YarinAVI/Practical-Engineer-Final-Project/BOOK/ספר פרויקט סופי.pdf

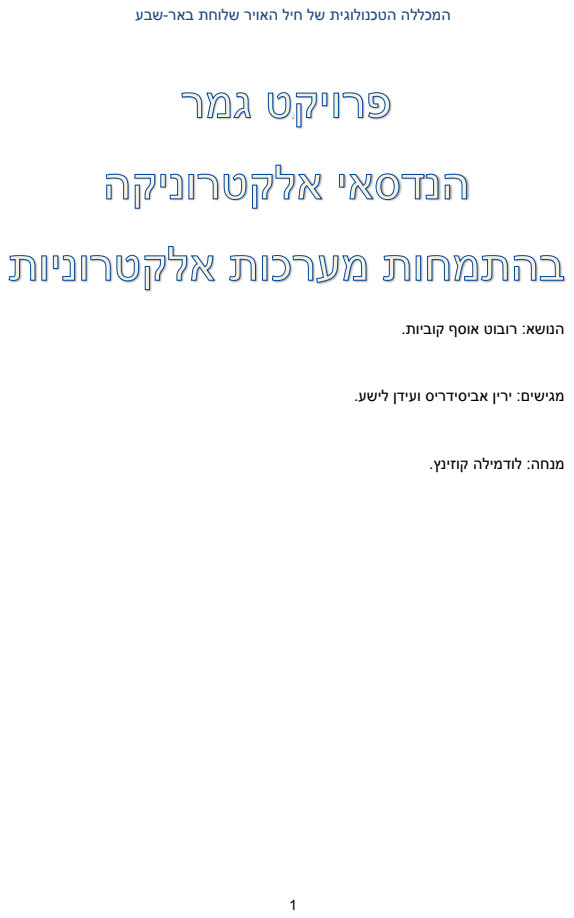
[picture p33: page 1]

המכללה הטכנולוגית של חיל האויר שלוחת באר-שבע

הנושא: רובוט אוסף קוביות.

מגישים: ירין אביסידריס ועידן לישע.

מנחה: לודמילה קוזינץ.

ברצוננו להודות למספר אנשים שעזרו, תמכו ותרמו מזמנם לעשייה וגימור הפרויקט.

בראש ובראשונה תודה למנחת הפרויקט - לודמילה קוזניץ , אשר תמיד עזרה והקשיבה לאורך כול תהליך בניית הפרויקט וכמובן הדריך והראה את הדרך הנכונה והשלבים לעשייה בצורה הטובה ביותר.

תודה למורים – ישראל זוניס ויעקב מרש, שליוו אותי במשך כול תקופת הלימודים, ונתנו לי את הידע והבסיס לעשיית הפרויקט ותמיד נענו בחיוב לעזרה בשעת הצורך.

## תוכן עניינים:

פרק 1 – מבוא

1.4 הסבר תרשים מלבנים | 8-9
8 | P89V51RD2 | בקר- | מיקרו | 1.4.1
8 | DC–L293D | למנועי | דרייבר | 1.4.2
1.4.3 מנועי DC8 |
1.4.4 מערך מקלטי/משדריIR8 |
1.4.5 חוצץ 24474HCT9 |
1.4.6 מנועי סרבו9 |
1.4.7 תצוגרת LCD9 |

פרק 2–מעגל חשמלי

2.1 סכימה חשמלי10 |
2.2 הסבר סכימה חשמלית10-34 |
11-20 | P89V51RD2 | בקר | מיקרו | 2.2.1
2.2.2 תזמון המיקרו-בקר בתדר קבוע20 |
2.2.3 מעגל ריסט )Circuit Reset ) 20 |
2.2.4 מעגל בקרת מנועים21-24 |
2.2.5 חיישן מרחק מבוסס קול אולטרסאונד )04SR-HC )26-28 |
2.2.6 ממיר מסוג STEPDOWN29 |
29 | PL-IRM0101 2.2.7
2.2.8 מנועי סרבו ) Motor Servo) 30-34 |

פרק 3 –פרוטוקולים

35-38 | )IR( RECS | פרוטוקול | 3.1

פרק 4–תוכנית

4.1 תוכנית בשפת C39 |
4.1.1 תרשים זרימה40 |
4.1.2 קבצי h41-51 |
4.1.3 תכנית ראשית52-59 |
4.1.4 הסבר פונקציות60-62 |

### פרק -5סימולציות

5.1 סימולציית PWM ב- Keil63-67 |

### פרק -6סיכום ומסקנות

6.1 סיכום ומסקנות69 |
6.2 תקלות במהלך הפרויקט69 |

### פרק -7זיווד71-73 |

### פרק -8ביביליוגרפיה

8.1 אתרים75 |

### פרק -9נספחים

76-82 | P89V51RD2 | בקר- | מיקרו | 9.1
9.2 דרייבר דוחף זרם למנוע D293L83-84 |
9.3 אפנון PWM(אפנון רוחב הפולס(85-86 |
9.4 מד מרחק (04SR(87-88 |
89 | DC Motor 9.5
9.6 מנועי סרבו (SERVO (90 |
9.7 מייצב ממותג מסוג BUCK) Down Step(91-93 |

## פרק :1

## מבוא

בפרויקט זה פותח ומומש רובוט בצורת טנק שעליו מורכבת זרוע מכנית אשר נועדה להרים חפצים מהרצפה ולהחזירם אל ארגז אשר מונח בפינת החדר .

הפרויקט מורכב מהרובוט עצמו ושלט לתפעולו של הרובוט . הרובוט מורכב מבסיס טנק בעל שני מנועי DC , גלגלים המשולבים עם רצועות גומי , מיקרו אשר משמש כליבה של המערכת ודרכו מתנהלות כול הפקודות והנתונים לשאר הרכיבים, מתח הספקה על מנת לתפעל את כול רכיבים , פרוטוקול IR שתפקידו לקלוט מהשלט מידע , מייצב מתח של v5 לרכיבים הלוגים הנמצאים במעגל , חיישן מרחק אשר יהווה עבור הרובוט כבקרה להפסקת תנועתו בהבחנת מכשול –כלומר החיישן יחובר למנוע סרבו על מנת שינוע בתנועת סריקה ימינה ושמאלה, מצב זה פועל רק במצב אוטומטי בלבד. השלט מורכב מפרוטוקול IR שתפקידו זהה ל- IR המצוי על הרובוט ובנוסף לשמש לתפעול שני מצבים של הרובוט, סוללת הספקה לשם תפעול השלט, לחצני חצים ולוח מקשים ממוספר למימוש תנועתו של הרובוט והזרוע. הרובוט יבצע את הפעולות אשר המשתמש יגדיר לו כגון : נסיעה קדימה, רברס, פניות ימינה ושמאלה תוך מתן התחשבות לסביבתו ,במצב אוטומטי כאשר הרובוט נמצא בחדר מרובע במידה וישנם מכשולים אשר מפריעים לו בדרך הוא ימנע מהם ע"י שינוי כיוון תנועתו לשם השלמת הנסיעה בצורה מושלמת ולאחר מכאן ישוב לביצוע פעולות המשתמש.

### 2.1 הוראות הפעלת המערכת

.1 מעבירים את הרובוט למצב כוח חיצוני )מתח סוללה אינו מקבל מתח מכניסת ה-usb). .2מחבברים פיזית את הכבלים של הסוללה לרובוט. .3 משתמשים במקור מתח נפרד של v5 שיכול לספק עד A3 לפי הדרישות להפעלת שלושת מנועי הסרבו של הזרוע במקביל. .4 כרגע הרובוט מוכן לקבל פקודות מהשלט כלומר הרובוט מוכן לשימוש )נסיעה+ זרוע(.

# LCD

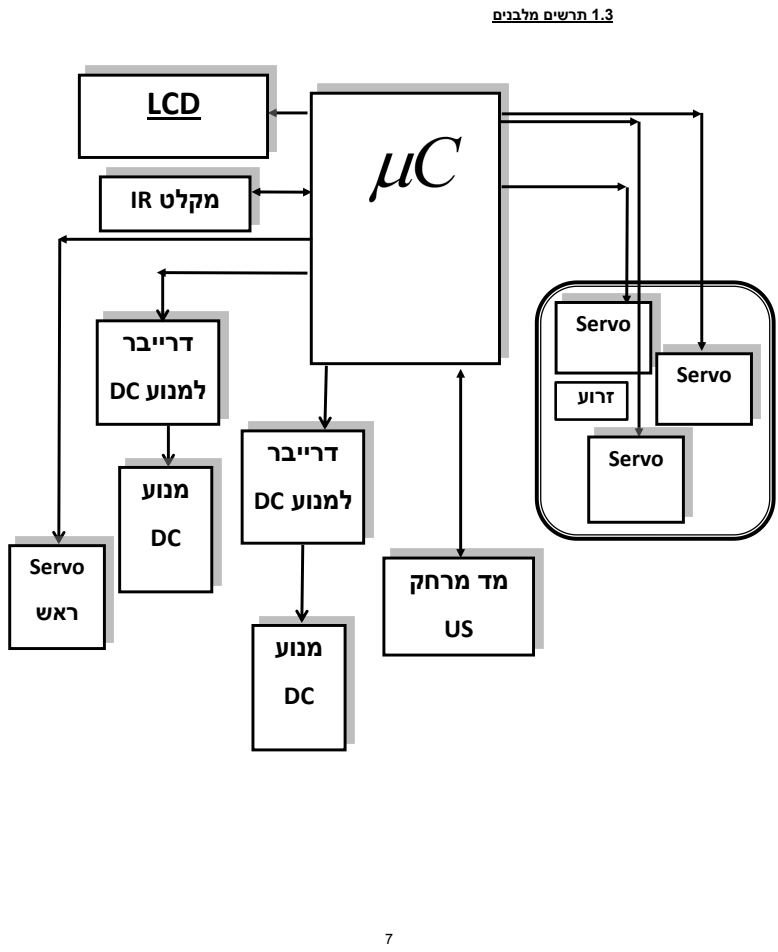
[picture p34: page 7]
1.3 תרשים מלבנים; Servo; דרייבר; למנוע DC; מקלט IR; מנוע; מד מרחק; ראש; זרוע

### 4.1 הסבר תרשים מלבנים

P89V51RD2 | בקר | מיקרו | 74.1.4

המיקרו בקר הוא היחידה המרכזית במעגל החשמלי.

תפקידו הוא לבקר על פעילות כל היחידות המחוברות אליו.

תפקידיו העיקריים של המיקרו בקר:

הפעלת מנועי ה- DC ע"י שליחת נתונים לדרייבר D293L.

עיבוד הנתונים המתקבלים מחיישני ה- IR ומחיישן ה- Ultrasonic.

יצירת פולסים מתאימים למנועי הסרבו בשביל תפעול הזרוע והזזת הראש עליו יושב החיישן מרחק.) PWM )

7L293D–DC | למנועי | דרייבר | 4.1.1

רכיב דוחף זרם אל המנועים. מחובר בין המיקרו בקר והמנועים.

תפקידו הוא לספק את הזרם הנדרש למנועים להפעילם בהתאם למידע שנשלח אליו מהמיקרו בקר.

### 4.1.1 מנועי DC7

רכיב אלקטרו מכאני, המבצע המרה של אנרגיה חשמלית לאנרגיה סיבובית מכאנית.

תפקיד המנועים הוא לסובב את הגלגלים כך שהרובוט יוכל לנסוע.

### 4.1.1 מערך מקלטי/משדרי IR7

השלט IR שולח אור red-infra אשר נקלט בעינית המקלט, המידע משודר באמצעות האור, גל הנושא שלנו מאופנן בתדר [hz[k,38 הסיביות והזמנים שלהם מוגרד לפי פרוטוקול – 80\ NEC .RECS

### 4.1.3 חוצץ 244HCT774

תפקידו להעביר את אות המבוא למוצא מבלי להעמיס על המיקרו-בקר, הגברת זרם האות שיוצא מהבקר.

תפקידו העיקרי הוא להגן על הבקר.

### 4.1.4 מנועי סרבו7

אנו משתמשים ב 3 מנועי סרבו עבור הזרוע כאשר 2 מתוכם לצירים של הזרוע ימינה\שמאלה, למעלה\למטה ומנוע אחרון לסיגרה ופתיחה של צבת הזרוע.

המנוע הרביעי משמש כ"ראש" להזזה של החיישן מרחק שמאלה וחזרה קדימה כדי לקבל משוב על המרחק של הרובוט מאובייקטים קדימה\שמאלה ועל ידי כך לצאת מהחדר שבנינו.

מנוע הסרבו שונה ממנוע ה DC בכך שהוא מקבל פולסים ולפי כך הוא מבין לאיזה כיוון הוא צריך להזיז את הגיר שלו בכדי להגיע לזווית הרצויה.

### 4.1.5 תצוגרת LCD7

רכיב LCD הוא קיצור של Display Crystal Liquid ובעברית תצוגת גביש נוזלי. הינו התקן אופטואלקטרוני אשר מסוגל להציג אותיות ,מספרים ותווים אחרים.

הוא משמש כיחידת פלט במערכת.

בעזרת ה lcd קיבלנו משוב על מדידת המרחק, השתמשנו בתצוגה כדי לראות שהרובוט נכנס למצבים שאנו רצינו להכניס אותו ובכך יכולנו לאתר שגיאות ובעיות שהיו בדרך.

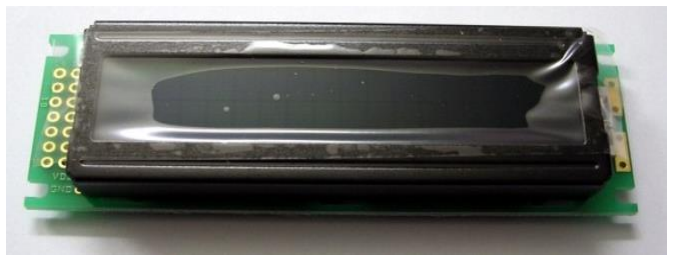
[picture p35: figure]

## פרק 71

## סכימה חשמלית

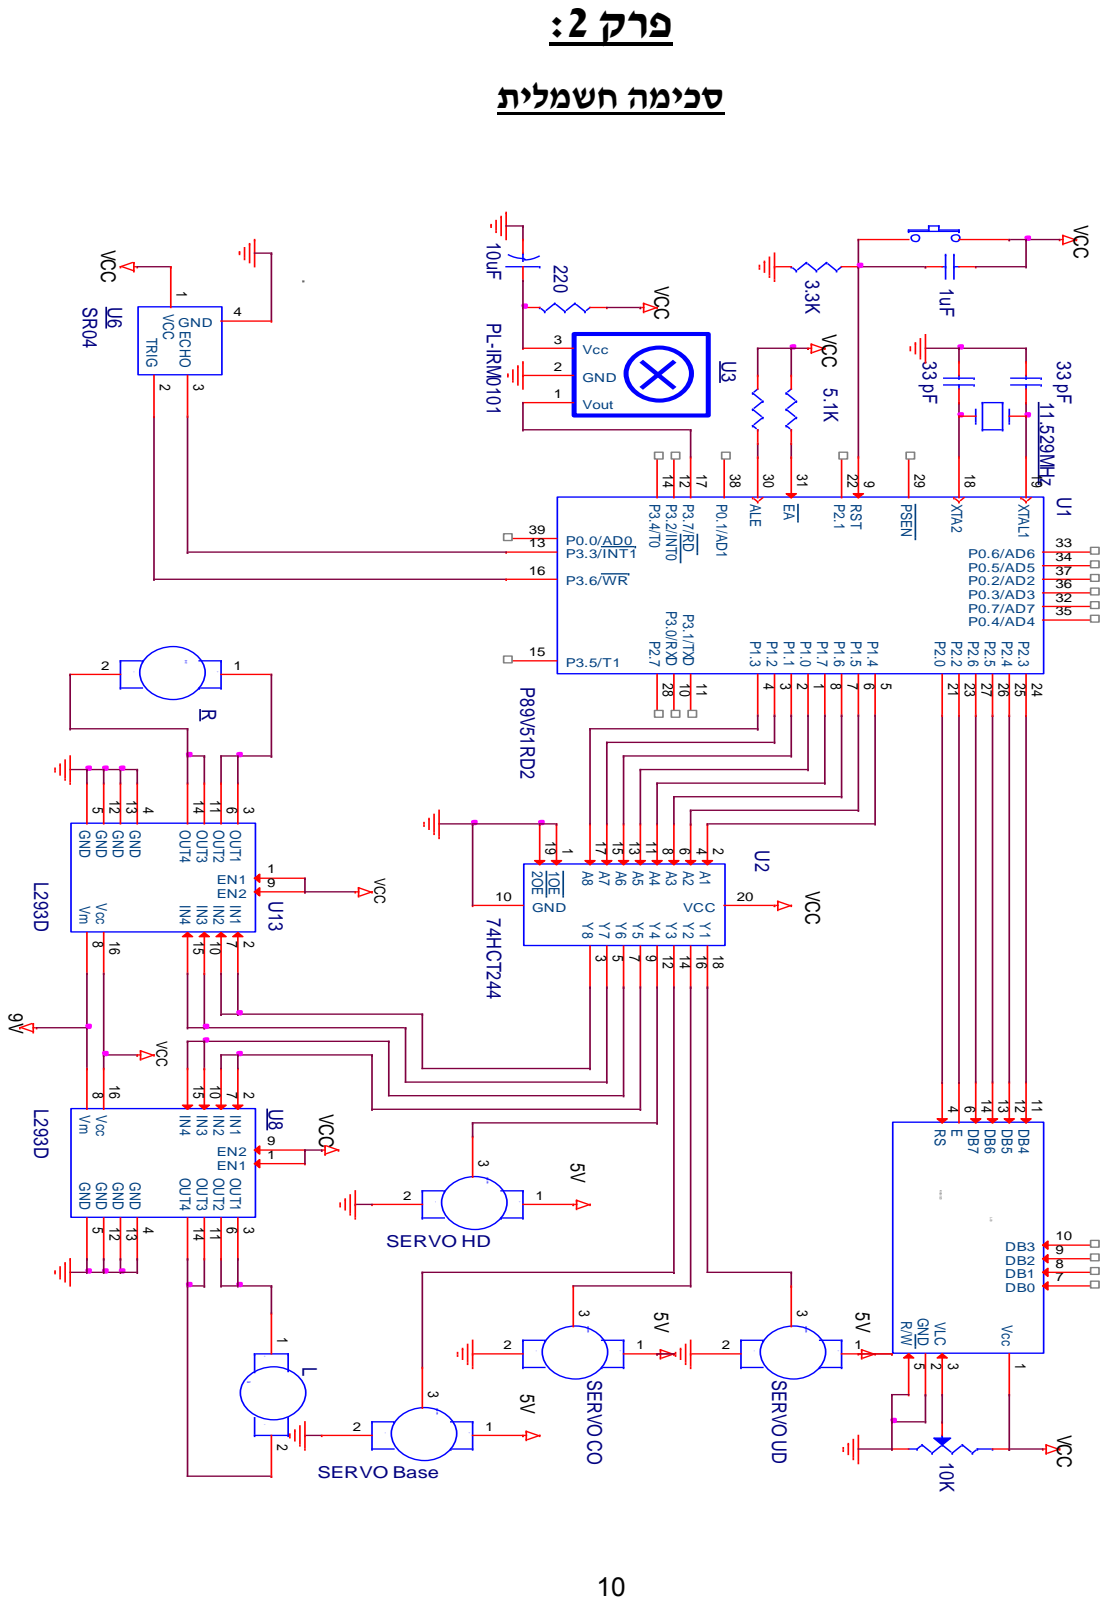
[picture p36: page 10]
OUT1; OUT2; OUT3; OUT4; GND; Vcc; 74HCT244; 12 VCC 20 GND 10; VCC; GND 2 VLC; 11.529MHz; LCD; PSEN; ALE; XTAL1; XTA2; RST; 28 P3.0/RXD 10 P3.1/TXD; P3.2/INT0; 12 P3.3/INT1 13; servo; SERVO UD; PL-IRM0101Vout; TRIG; ECHO; 3 GND

servo SERVO HD

servo SERVO CO

servo SERVO Base

### 1.1 הסבר סכימה חשמלית

7P89V51RD2 | בקר | מיקרו | 1.1.4

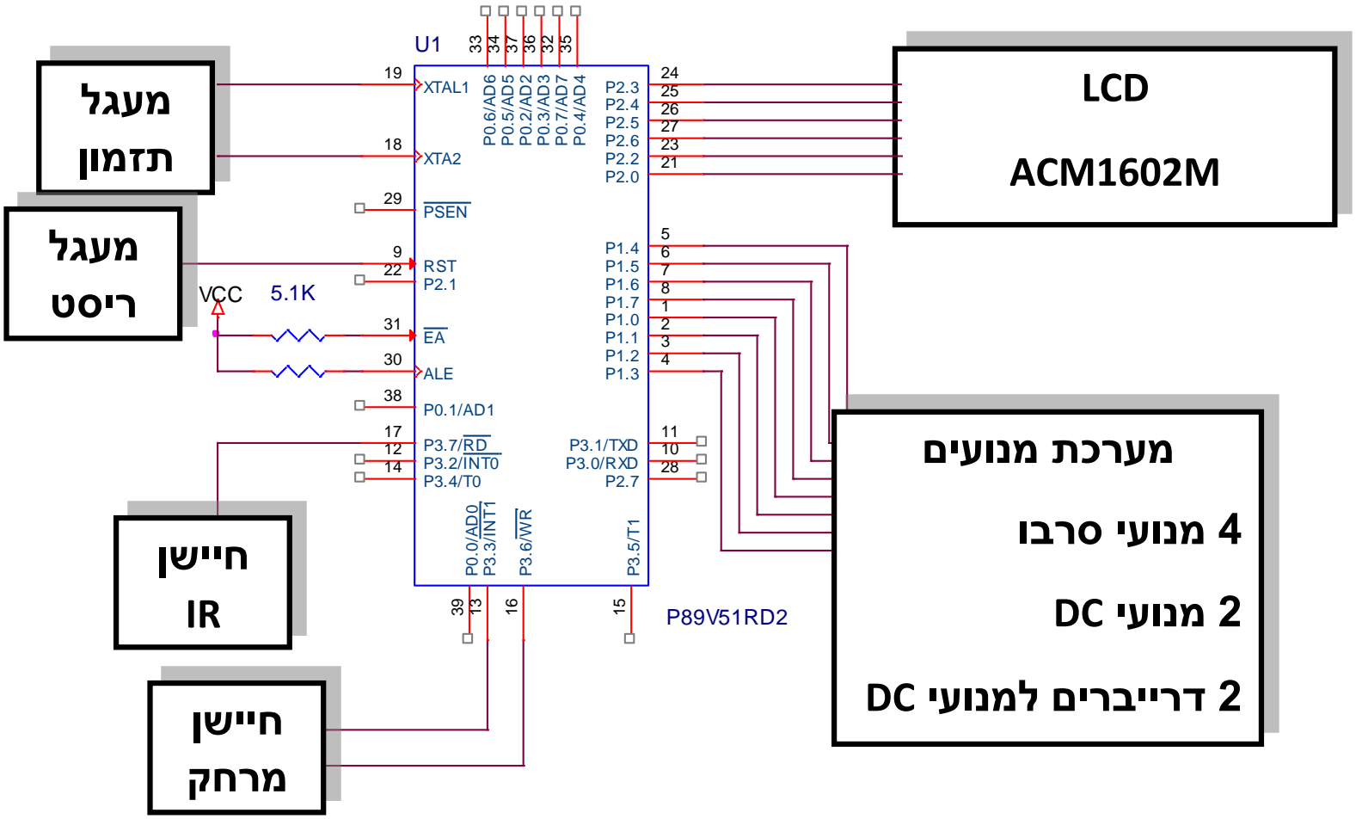
[picture p37: figure]
LCD; ACM1602M; מעגל תזמון; VCC; PSEN; ALE; XTAL1; XTA2; RST; P⁰.0/AD⁰ 39; P3.0/RXD; P3.1/TXD; P3.2/INT0; P3.3/INT1; מערכת מנועים; 4 מנועי סרבו; 2 מנועי DC; 2 דרייברים למנועי DC; מעגל ריסט; חיישן IR; חיישן מרחק

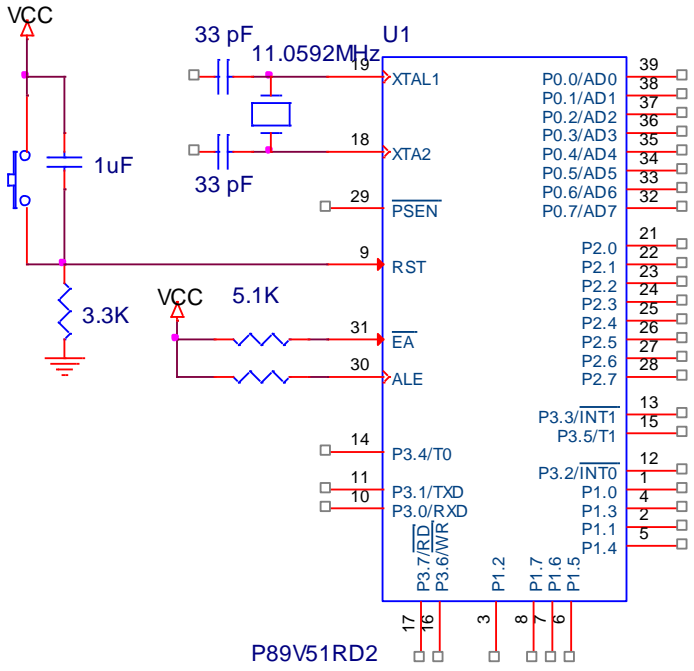
[picture p38: figure]
PSEN; ALE; XTAL1; XTA2; RST; P3.0/RXD; P3.1/TXD; P3.2/INT0; P3.3/INT1; 11.0592MHz; VCC

מיקרו בקר 2RD51V89P של חברת NXP הוא היחידה המרכזית במעגל, והוא אחראי על כל היחידות המחוברות אליו.

תפקידיו העיקריים בפרויקט:

- הפעלת המנועים על מנת שהרובוט יוכל לנסוע.
- קריאת נתונים מחיישני ה –IR לשם תנועת הרכב והזזת הזרוע .
- קריאת נתונים מחיישן ה –Ultrasonic במצב אוטומטי כדי שהרכב ידע היכן נמצאת היציאה של החדר.
- גילוי יציאת החדר.
- קריאת נתונים המתקבלים מהמחשב דרך תקשורת טורית אסינכרונית.

מאפיינים7

מאפיינים:

2RD51V89P של חברתNXP הוא מיקרו בקר מסדרת 51C80 עם זיכרון תוכנה KbytesFlash64 ו- BytesRAM.1024

CP של מיקרו בקר 51C.80

זיכרון תוכנה פנימי Flash Kbytes.64

UART משופר.

Array Counter Programmable – PCA –מערך מונים הניתנים לתכנות הכוללים פונקציית .PWM

4 פורטים של קלט/פלט מקביליים בגודל bit8 כל אחד.

3 טיימרים/מונים בגודל bit.16

Watchdog טיימר הניתן לתכנות.

8 מקורות פסיקה עם 4 רמות של עדיפויות.

תיאור חיבורים במיקרו בקר7

- הדקים 1X ו- 2X הם קווי חיבור של גביש לתזמון הרכיב כאשר תדר העבודה הוא תדר הגביש.
- 1PORT –אליו מתחברים מנועי ה-DC, הדרייברים שלהם ומנועי הסרבו של הזרוע, דרך רכיב הגנה .
למנוע אחד מתחברים ההדקים 1.0P ו- 1.1P ולמנוע השני מתחברים ההדקים 1.2P ו- 1.3P.

על מנת להפעיל את המנוע צריך להיות הפרש מתח בין הפורטים המחוברים אליו.

הדקים 1.4P עד 1.7P מחוברים למנועי הסרבו אשר מפעילים את הזרוע .

- 2.0P ו- 2.2P עד 2.6P אליהם מחובר ה- LCD המשמש לנו לבדיקת נתוני הרובוט.
- 3.7P מחובר לחיישן IR אשר נועד לקבל פקודות מהשלט IR לגבי תנועות הרובוט והזרוע על ידי פרוטוקול IR .
- 3.3P ו- 3.6P אליהם מחובר חיישן האולטרסאונד 3.3,P הדק זה הוא פסיקת 1INT המחובר להדק ה ECHO של חיישן האולטרסאונד הדק 3.6P משמש להדק ה- TRIG.

תכונות מיוחדות של המיקרו בקר7

פסיקות7

פסיקה זה גורם המפסיק את הפעילות השגרתית של המעבד.

כאשר מתקבלת פסיקה המעבד יפסיק את הרצת התכנית הראשית והוא יבצע את תכנית הפסיקה. בסיום תכנית הפסיקה המעבד יחזור לפעילות השגרתית עד שתתרחש פסיקה נוספת.

אוגרי המעבד:

. | פסיקות | אפשור | אוגר | – Interrupt enable register 0 – IEN0

0EX – אפשור פסיקה חיצונית .0

0ET – אפשור פסיקת טיימר .0

1EX – אפשור פסיקה חיצונית .1

1ET – אפשור פסיקת טיימר .1

ES – אפשור פסיקת פורט טורי.

2ET – אפשור פסיקת טיימר .2

EA – על מנת להשתמש בפסיקה כלשהי יש לעלות את EA ל-'1'. על מנת לחסום את כל הפסיקות

יש להוריד את EA ל-'0'.

שימושים של הפסיקות בפרויקט:

פסיקת 1INT פסיקה חיצונית 1 פסיקה זו קשורה למדידת המרחק בעזרת החיישן ultrasonic .

0IP – priority Interrupt – אוגר לקביעת סדר עדיפויות של הפסיקות.

על מנת לתת עדיפות גבוהה יותר לאחת הפסיקות יש לעלות את הסיבית המתאימה ל- '1'.

כאשר כמה פסיקות בעלות אותה רמת עדיפות, העדיפות תהיה בהתאם לסדר העדיפויות כך ש-0PX היא בעלת העדיפות הגבוהה ביותר.

TMOD – register control mode Counter/Timer – אוגר לבקרת אופן עבודה של טיימר/מונה.

CT – Timer/Counter – סיבית זאת קובעת פעולת מונה אירועים או טיימר.

'0' בסיבית זו קובע אופן פעולה של טיימר. )מהשעון הפנימי(.

'1' בסיבית זו קובע אופן פעולה של מונה. )כניסה מהדק Tx של המיקרו בקר(.

GATE – כאשר סיבית זו ב-'1' המונה/טיימר יופעל רק כאשר בהדק 'INTx יש '1' ובהדק TRx יש .'1'

כאשר סיבית זו ב-'0' הטיימר יופעל כאשר בהדק TRx יש '1'.

0M1,M – סיביות לקביעת אופן הפעולה של הטיימר/מונה.

הטבלה הבאה מציגה את אופני הפעולה הנפוצים יותר:

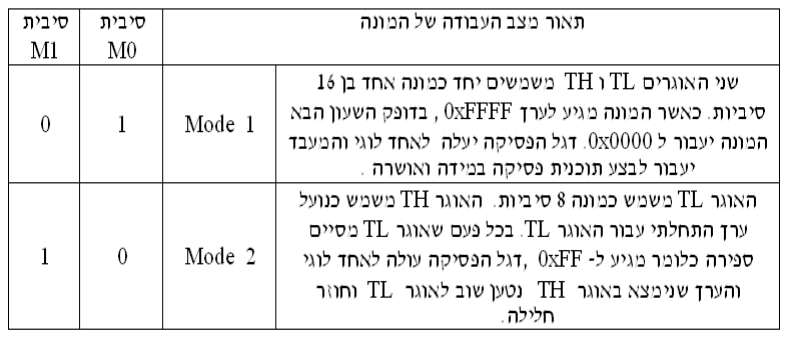
[picture p39: figure]

שימושים של הטיימרים בפרויקט:

- במצב הבקרה הידנית כאשר הרכב נתון לשליטה על ידי השלט, 0timer נמצא ב 2Mode bit8 טעינה אוטומטית כדי ליצור פולס מתאים לשליטה על מנועי הסרבו כמו שידוע מנועי הסרבו דורשים PWM כדי לסובב את הגיר שלהם לזווית הרצויה. 1Timer נמצא ב 1Mode bit16 כדי לקלוט נתונים מהחיישן IR.
- במצב הבקרה אוטומטית 0Timer נשאר באותו מצב כדי לשלוט על מנועי הסרבו, אך 1Timer כרגע עם פסיקות כדי למדוד את המרחק מחיישן ה ultrasonic השינוי זה בטבלה הבאה:

GATE של 1timer" 1 "בהגדרה זו רק כאשר הדק ה 1INT יעלה ל 1 הטיימר יחל לעבוד וכאשר ייפול ל '0' לוגי יתקבל פסיקת 1INT שהיא מטפלת במדידת המרחק.

. | טיימר | /מונה | לבקרת | אוגר | – Timer/Counter control register – TCON

0,1IT – סיביות אלו קובעות מתי תתרחש פסיקה.

'0' בסיבית זו – פסיקה תתרחש כאשר 0,1INT ברמה נמוכה.

'1' בסיבית זו – פסיקה תתרחש כאשר יש עלייה מ-'0' ל-'1' ב- 0,1INT.

0,1IE – סיבית זו עולה ל-'1' כאשר התרחשה פסיקה.

סיבית זו מתאפסת כאשר מתבצעת תכנית הפסיקה.

0,1TR – סיביות להפעלה/כיבוי של הטיימר/מונה)'1' – הפעלה, '0' – כיבוי(.

0,1TF – סיביות אלו עולות ל-'1' כאשר הטיימר/מונה סיים את הספירה.

סיביות אלו מתאפסות כאשר המעבד מבצע את תכנית הפסיקה הרלוונטית.

שימושים של אוגר זה בפרויקט:

- במצב בקרה אוטומטית של הרובוט אנו משתמשים בחיישן ה ultrasonic, ובכדי להשתמש בו אנו צריכים להגדיר את הפסיקה 1int וקבענו 1=1IT זאת אומרת תתקבל פסיקה כאשר הדק ה ECHO של החיישן ירד ל ‘0’ לוגי. להלן קטע קוד:
1. EX1=1; //enabling interrupt 1
2. TR1=1; // running timer 1, timer runs when gate is 1.
3. IT1=1; // falling edge interrupt 1
4. EA=1; // enabling all interrupts

– Programmable Counter Array – PCA

מערך המונים PCA מורכב מחמשה מודולים הניתנים לתכנות באופני עבודה שוני וממונה משותף בן 16 סיביות המורכב משני אוגרים של 8 סיביות ) CHו CL) .

אחד מאופני העבודה של ה- PCA הוא PWM שבו אנו משתמשים לבקרה על זווית גיר מנועי הסרבו.

אוגרים מיוחדים שבעזרתם מאתחלים את ה- PCA:

- PCA counter control register – CCON

CCFX – סיביות פסיקה המשמשות עבור 5 המודולים. סיביות אלו עולות ל-'1' כאשר מתרחשת פסיקה מתאימה )אנחנו לא משתמשים בסיביות אלו בפרויקט(.

CF – Flag Overflow Counter PCA – סיבית זו עולה ל-'1' כאשר המונה של ה- PCA מסיים את הספירה. ניתן להשתמש בדגל זה בשביל פסיקה של המונה.

CR – Bit Control Run Counter PCA – באמצעות סיבית זו מפעילים את המונה.

ההוראה שאנו משתמשים על מנת להפעיל את המונה:

1. CCON=0x40;

PCA counter mode register – CMOD

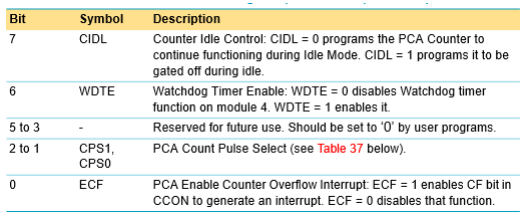
[picture p40: figure]

CIDL-בקרת מנייה במצב IDLE כאשר ‘0’ המונה ימשיך לפעול במצב ה IDLE, כאשר הוא יהיה ‘1’ הPCA לא יפעל במצב ה IDLE.

WDTE- אפשור הפעלת טיימר של WATCHDOG"( כלב שמירה" ( תפקיד הWATCHDOG בבקר היא לבדוק שהבקר עובד כשורה ועושה את כל הפעולות כמתוכנן וגם בודק שהבקר מפיק תדר שעון שזה הרי גורם חשוב בפרוייקט.

כאשר 0=WDTE טיימר של ה WATCHDOG לא יפעל וכאשר ‘1’ הטיימר יפעל.

0CPS1,CPS-סיביות אלו משמשים ב בחירת פולס מתאים לביצוע המנייה של ה PCA מתוך 4 אופציות שהיצרן מציע.

ECF- אפשור פסיקת המנייה של PCA כאשר מתקבלת גלישה, כאשר סיבית זו ‘1’ לוגי היא מאפשרת לסיבית CF באוגר CCON ליצור פסיקה, כאשר סיבית זו ‘0’ היא מחסלת אפשרות זו.

Counter pulse select options:

באמצעות הפקודה הבאה אנו בוחרים פולס ספירה מתאים בין 4 האפשרויות שהיצרן מציע, אנו בחרנו לעבוד עם גלישת 0timer כדי לבצע את הספירה.

1. CMOD=4;

CCAPMn PCA Modules Compare/Capture register

- חשוב לציין שאוגר זה רלוונטי עבור הפורטים 1.7P1.3-P שרק עבורם אפשר להוציא אות PWM עבור מנועי הסרבו, היצרן מציע 5 הדקים שעבורם אפשר להוציא PWM ברקע לתוכנית הראשית.

ECOMn-מאפשר את פעולת המשווה עבור הדק ה n,’ 1 ‘לוגי יאפשר את הפעולה.

CAPPn- אופצית ה CAPTURE חיובית עבור הדק ה n,’1 ’אומר שהוא עובד עבור עלייה חיובית.

CAPNn- אופצית ה CAPTURE שלילית עבור הדק ה n,’ 1 ‘אומר שהוא עובד עבור ירידה בהדק ה .n

TOGn- כאשר סיבית זו ‘1’ וכשיש שיוון בין המנייה של ה PCA לבין המנייה של אוגר זה הדק ה n שנבחר מבצע מיתוג בין המצב הנוכחי שלו למצב ההופך )TOGGLE)

PWMn- סיבית זו מאפשר את ההדק n להיות מוצא PWM

להלן איור שמתאר את ההדק כשהוא מתפקד עם PWM ביציאה שלו:

באמצעות אוגרים CCAPnH ו- CCAPnL קובעים את ה- Cycle Duty של האות.

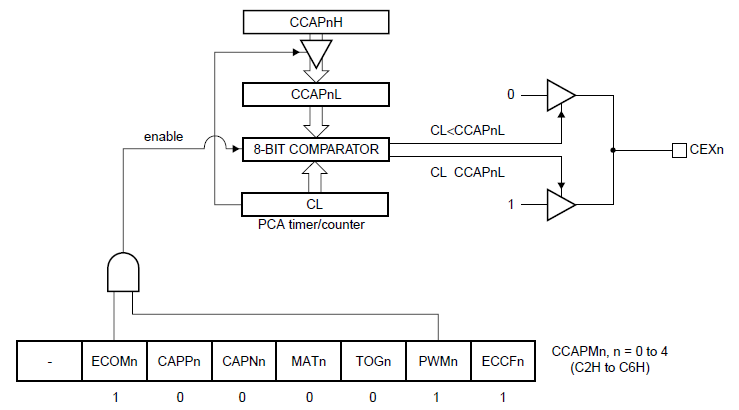
[picture p41: figure]

כשמונה מתחיל לספור, כל עוד התוכן שלו קטן מהערך באוגר CCAPnL במוצא יהיה '0'.

כאשר הערך שבאוגר CCAPnL גדול מהערך של המונה במוצא יהיה '1'.

כשמסתיימת הספירה האוגר CCAPnL נטען בערך של אוגר CCAPnH והמונה סופר מחדש, כך שמתקבל אות מחזורי במוצא עם Cycle Duty שניתן לבחירה.

בפרויקט אנו מייצרים אות PWM בהדקים 1.7P1.4-P עבור שליטה על מנועי הסרבו שאיתם אנו מזיזים את החיישן ultrasonic ושאר המנועים אשר מהווים צירים לזרוע שנמצאת על הרכב, סה"כ 3 מנועי סרבו לזרוע שלנו כאשר מנוע1 מהווה ציר אופקי המנוע השני לציר אנכי והמנוע השלישי לסגירה\פתיחה של הזרוע בכדי להרים חפצים.

### 1.1.1 תזמון המיקרו-בקר בתדר קבוע7

מעגל תזמון של המיקרו-בקר מורכב מגביש של Mhz 11.0592 ושני קבלים שערכם pF.33 מעגל זה משמש ליצירת תדר השעון הנחוץ לעבודה תקינה של מיקרו בקר )קריאה, כתיבה, הפעלת רכיבים פנימיים, קריאה לפריפריה(.

במקביל.
33ρF

כדי לקבל תדר מדויק מחברים לגביש שני קבלים בעלי ערך של

ערך הקבלים נבחר לפי דפי יצרן של המיקרו בקר. מעגל )מתנד בעל תדר MHz11.0592 ושני

קבלים אשר מכניסים אותו לתדר תהודה( מהווה רשת משוב B של מתנד קולפיץ. המגבר של מתנד

זה ממומש ע"י שער NOT פנימי שבמיקרו בקר.

השתמשנו בגביש ולא בסליל מפני שבמעגל דיגיטלי לא מומלץ להשתמש ברכיבם בעלי השראות וגם כן הגביש מדויק יותר.

מעגל תזמון משמש ליצירת תדר שעון לשם הבטחת סנכרון )כלומר לשם שמירת תדירות קבועה ויציבה של עבודת הבקר( של כל פעולות המבוצעות ע"י בקר.

הדקים 1X ו- 2X הם קווי חיבור של גביש לתזמון הרכיב כאשר תדר העבודה הוא תדר הגביש.

### 1.1.1 מעגל ריסט ) Circuit Reset) 7

מעגל הריסט שלנו ממומש באמצעות לחצן O.N קבל uF1 ונגד k3.3 חיבור הלחצן הוא בתצורת down-pull, כאשר אנו נלחץ על הלחצן זרם יזורם דרך מסלול vcc<קבל>נגד ויצור מפל מתח על הנגד שמפורש כ- HIGH בהדק ה RESET של הבקר, לפי דרישות היצרין מתח HIGH בהדק ה RESET למשך זמן של 2 זמני מכונה במקרה שלנו בערך us2 יגרמו לבקר לעשות RESET.

תפקיד הקבל הוא למנוע את בעית הריטוטים שנוצרת עקב הלחיצה המכאנית של האדם.

3.3K

1uF

VCC

RESET_CIRCUIT

RST(9)

### 2.2.4 מעגל בקרת מנועים:

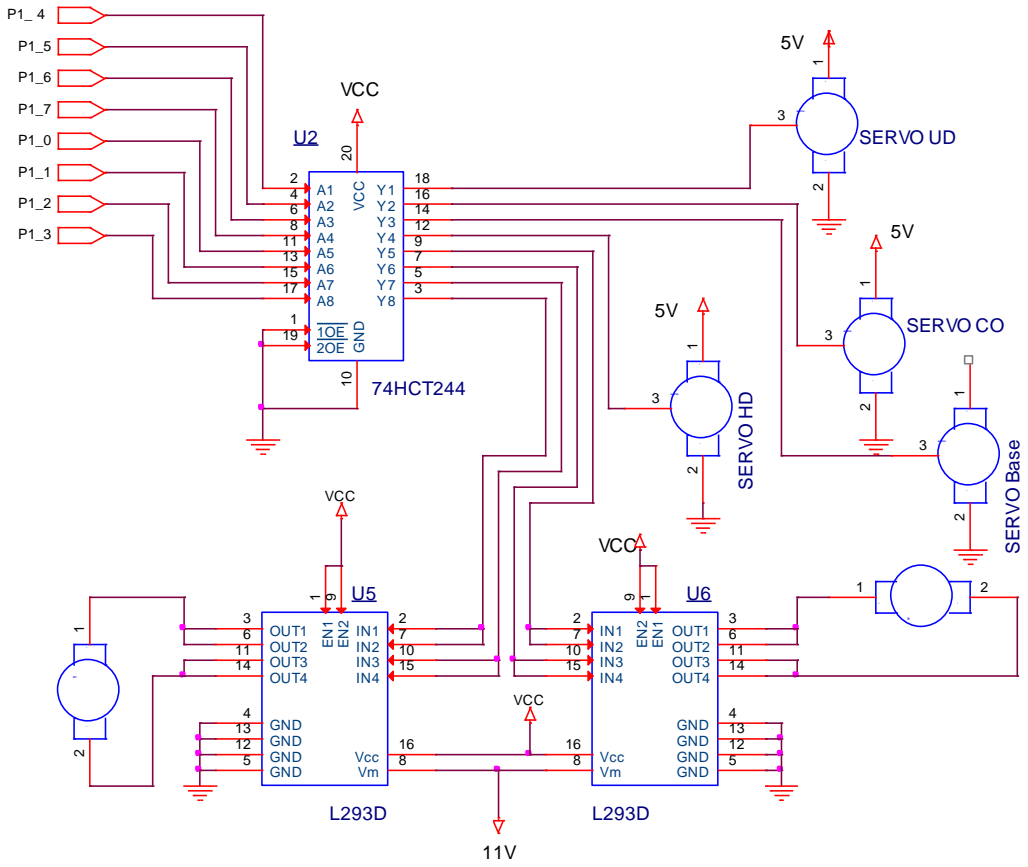
[picture p42: figure]
15 EN¹; OUT1; OUT2; OUT3; OUT4; GND; Vcc; 74HCT244; 12 VCC ²⁰ GND 10; VCC; servo; SERVO CO; EN¹; SERVO HD; SERVO UD; SERVO Base

לרובוט מחוברים שני מנועים שמטרתם היא להזיז את הרובוט קדימה, ימינה שמאלה ואחורה.

בנוסף מחוברים 4 מנועי סרבו כאשר שלוש מתוכם לשם שליטה על הזרוע של הרכב והאחרון לשם הזזה של חיישן המרחק.

מנוע DC:

רכיב אלקטרו-מכאני המבצע המרה של אנרגיה חשמלית לאנרגיה מכאנית.

מנוע DC מבוסס על עקרון האלקטרומגנטיות, המאפשר יצירת שדה מגנטי על ידי העברת זרם חשמלי דרך סליל.

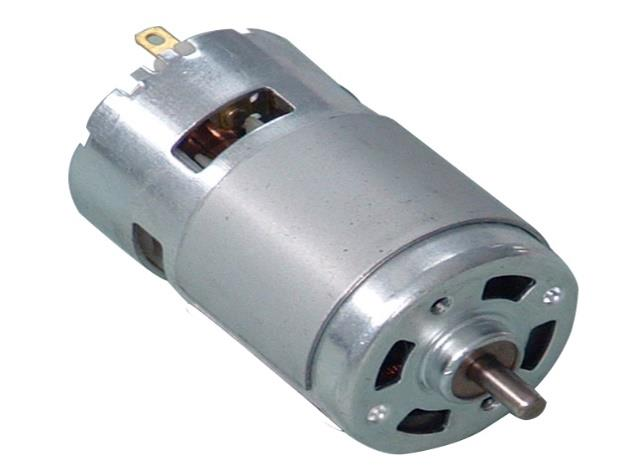
[picture p43: figure]

אספקת מתח למנועים7

- לקחנו סוללת ליתיום V11.1 בעלת הספק של mAh1000 חיברנו אותה למטריצה והיא

מוציא לנו V10 מהנקודה הזו חיברנו מתח למנועי ה DC

•חיברנו בנוסף ממיר STEPDOWN שיורד את המתח למתח נמוך יותר שמתאים למננועי ה

SERVO שהוא מתאים לפי דרישות היצרן ל (v-7.4v5 (בחרנו לעבוד עם V6 ובכך הצלחנו

להפעיל 2 מנועי DC ו 4 מנועי סרבו בעזרת סוללה אחת ברור שההספק של המנועי סרבו משתנה ותלוי האם הזרוע מרימה חפץ או האם אנו משתמשים בזרוע תוך כדי נסיעה.

דרייבר דוחף זרם D293L:

תפקיד הדרייבר הוא לספק זרם למנועים, מכיוון שהזרם שהמיקרו בקר יכול לספק מהפורטים שלו לא מספיק גדול בשביל הפעלת המנועים.

כל ערוץ )מוצא של הדרייבר( יכול לספק עד A.0.5 אנו מחברים שני ערוצים לכל מנוע על מנת

לאפשר זרם של עד A.1

הדקים 1EN ו- 2EN מאפשרים את הערוצים 1,2OUT ו- 3,4OUT בהתאמה, כמוראה בטבלה:

H – רמה גבוהה

L – רמה נמוכה

X – לא רלוונטי

Z – עכבה גבוהה

הידק Vcc – מתח של V5 מסופק לכניסות הלוגיות כדי לצמצם בזבוז הספק.

הידק Vm – מתח המוצא של הרכיב - V10 לכל מנוע.

תפקיד נוסף של הדרייבר הוא להפעיל את המנוע בשני כיוונים ע"י ספק יחיד באמצעות מעגל -H

:Bridge

Input | EN | Output
H | H | H
L | H | L
X | L | Z

ניתן לראות שעל ידי שינוי המתח בכניסות של הדרייבר אפשר למתג את המנוע בשני כיוונים שונים ומתח האספקה הוא עדיין Vm.

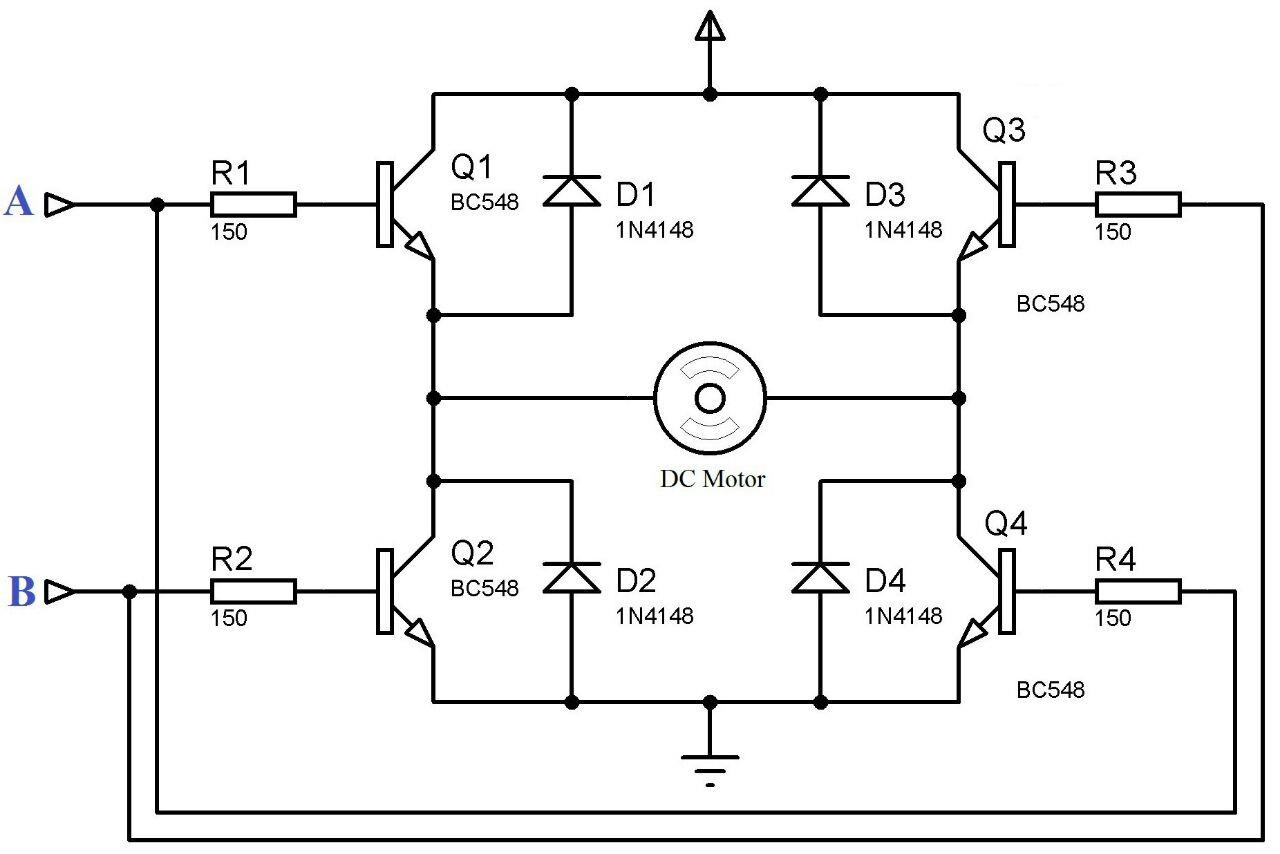
[picture p44: figure]

דיודת הגנה

המתגים שבמעגל BRIDGE-H הם טרנזיסטורים ולכן יש צורך להוסיף דיודת הגנה שתהיה מחוברת במקביל למנוע )עומס השראי(.

ב-D293L הדיודה בתוך הדרייבר ולכן הוסיפו את האות D לשם הדרייבר.

במצב מתמיד הזרם זורם דרך הסליל אשר מתנהג כקצר דרך הטרנזיסטור שנמצא ברוייה.

הבעיה היא כשמנתקים את 1V הטרנזיסטור נמצא בקיטעון ובגלל שאין קפיצות זרם בסליל הוא לא מספיק להתפרק.

במצב זה ללא דיודת הגנה הטרנזיסטור היה נשרף אך אם נחבר את דיודת ההגנה ניתן לראות שכשהטרנזיסטור נכנס לקיטעון מתח הסליל משנה את קוטביותו והוא מתפרק דרך הדיודה וכך הדיודה מגנה על הטרנזיסטור.

בזמן הטעינה של הסליל שינוי הזרם הוא חיובי אך בזמן הפריקה שינוי הזרם הוא שלילי ולכן המתח משנה קוטביות.

בקרה על סיבוב המנועים:

על מנת לגרום למנועים להזיז את הרובוט לכיוון מסוים יש לשלוח נתונים לפורטים להם מחוברים הדרייברים של כל מנוע. הנתונים הדרושים לפעולה זו מתוארים בטבלה הבאה:

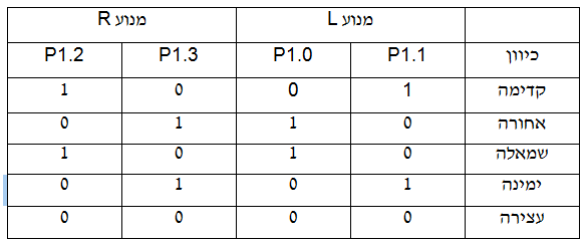
[picture p45: figure]

רכיב חוצץ – 244HCT774

תפקידו הוא להפריד בין המיקרו בקר לבין מעגל בקרת המנועים.

244HCT74 הוא חוצץ ל- bit8 עם 3 מצבי מוצא, לרכיב יש שני מוצאים של bit4 הנשלטים ע"י

הדקי OE.

פעולת הרכיב מתוארת בטבלה הבאה:

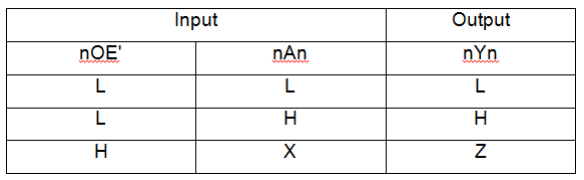
[picture p46: figure]

אנו מחברים את הדקים 'OE1 ו- 'OE2 לאדמה על מנת לאפשר את שני המוצאים, כדי שכל נתון שנשלח לחוצץ יעבור לדרייברים של המנועים.

### 1.1.1 חיישן מרחק מבוסס קול אולטרסאונד )04SR-HC):

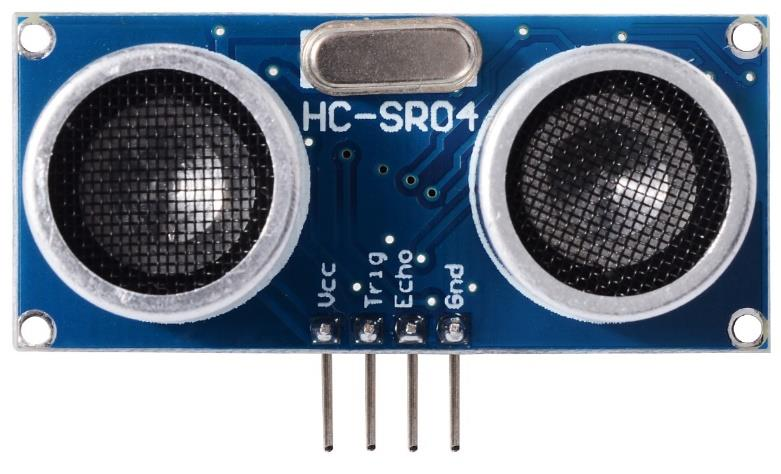
[picture p47: figure]
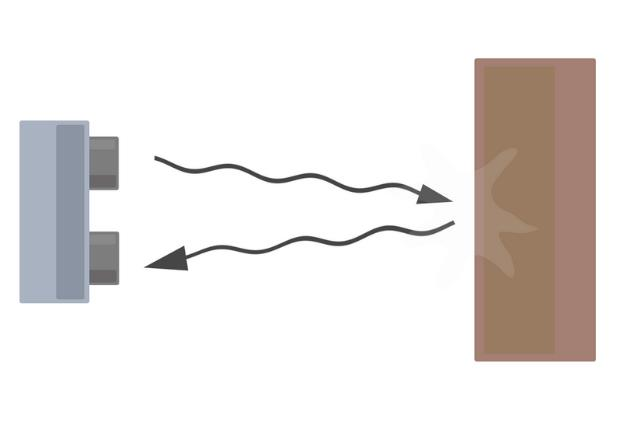
[picture p48: figure]

חיישן זה כולל משדר ומקלט, החיישן משדר קול אולטראסוני כאשר הוא מרגיש מתח HIGH ברגל ה- TRIGGER למשך זמן של לפחות us,10 לאחר סיום השידור של הקול האולטראסוני רגל ה ECHO עולה ל מתח HIGH עד שהמקלט מקבל את הקול חזרה ) זאת אומרת שהקול הספיק לחזור חזרה אל החיישן ( לפי הנתונים הללו ניתן להבין שהקול ביצע דרך כפולה, זאת אומרת הוא הספיק לפגוע באובייקט שנמצא מולו ולחזור חזרה אל המקלט ולכן את המרחק אשר נמודד בעזרת הTIMER בתוכנה נחלק ב.2

בעזרת הTIMER נמדוד את הזמן שלקח לקול האולטראסוני לחזור אל החיישן ובכך יהיה ניתן

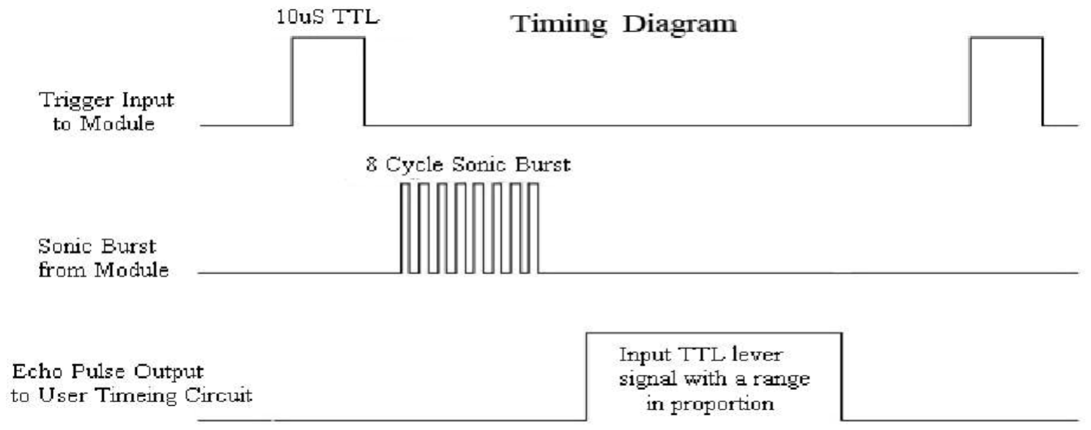
[picture p49: figure]

לחשב את המרחק מהאובייקט שממולו.

P3_6

VCC

US_SENSOR

U4
SR04

VCC

1

TRIG

2

ECHO

3

GND

4

P3_3

נשתמש בנוסחא ובטבלת יחידת המרת K הבאה :

| | ערך המרהK( מהירות( V( טמפרטורה( C ºt
0 | 331.5 | 60
10 | 337.5 | 59
20 | 343.5 | 58
30 | 349.5 | 57

בחרנו לעבוד עם ערך המרה 58=K כאשר טמפרטורת העבודה שלנו היא 20 מעלות.

בתוכנה הזמן שנמדד יחולק ב 58 ובכך יתקבל המרחק המדויק עבור טמפרטורת עבודה של 20 מעלות.

נשאלת השאלה כיצד אפשר לבצע מדידה מדויקת של מרחק בעזרת חיישן זה ?

על ידי הוספת חיישן טמפרטורה שבעזרתו נדע את טמפרטורת העבודה שלנו ובכך בעזרת התוכנה נוכל לבחור ערך המרה K מתאים ובכך נגיע למדידה מדוייקת של המרחק.

1. void us_trig() {// trigger function for ultrasonic sensor
2. trig=1;
3. nop();nop();nop();// delay of 14us
4. trig=0;
5. msec(50);
6. }

פונקציה למימוש ה TRIGGER שהיצרן דורש להוציא בהדק ה TRIGGER של החיישן יש לציין שהדרישה שלו היא פולס של us10 לפחות כאשר אנחנו נתתו לו us,14 בנוסף לכך יש לציין שלפי דרישות היצרן חייב להיות רווח של ms50 לפחות בין כל פולס ברגל ה TRIGGER.

1. void distance() interrupt 2{//interrupt function (echo fa lls int1 interrupt(
2. time =TH1;
3. time =time<<8;//shift left 8
4. time =time|TL1; //
5. dist=time/58;
6. TH1=TL1=0;
7. flag=1;
8. }

פונקציה זו היא פונקצית-פסיקה והתוכנית תכנס אליה רק אחרי שיצרנו פולס לחיישן בעזרת הפונקציה ()trig_us, כאשר הדק 3.3 של הבקר ירד ל-"0" לוגי תתקבל פסיקת 1INT מסוג edge-falling, רגל 3.3 של הבקר מחוברת לרגל ה ECHO של החיישן, ECHO עולה ל-"1" לוגי לאחר מתן TRIGGER וסיום שידור הקול ויפול ל-"0" לוגי כשהקול יחזור אל החיישן. בזמן ש ECHO נמצא ב-"1" לוגי 1TIMER רץ ומודד את הזמן שהוא נמצא ב-"1" לוגי ומפסיק למדוד כאשר הוא נופל ל-"0" לוגי, מיד מתקבלת פסיקה ותוכנית ישר קופצת לפונקציה זו כדי לטפל במדידת הזמן. למשתנה dist נכנס המרחק שנמדד ביחידות CM.

K

t s
V

V t s t s
S

[ ]

| 2/ [ ]
2
* [µ ] | µ | µ
= | = | =

חשוב לציין שאנו משתמשים בחיישן זה אך ורק כאשר אנו מפעילים את המצב האוטומטי כאשר הוא מתוכנת לצאת מחדר מרובע, ובכך הרובוט מחליט את כיוון הנסיעה לפי תוכנית שכתבנו ומשתמש בחיישן המרחק ככלי מפתח.

הטיימר שלנו עובד לפי זמן המכונה של הבקר שהינו בערך us,1 זאת אומרת הטיימר שלנו מונה זמן ב microseconds, מהירות הקול לפי הטבלה עבור טמפרוטת עבודה של 20 מעלות 343m/s הינה

אנו מעוניינים לקבל את המרחק מהחיישן ביחידות CM ולכן יש להמיר את המהירות ל US/CM, להלן הדרך:

| 340 | /
340*100 | 34000 | /
1sec 1
1000000
34000 ( | / | ) | 0.034 | /
1000000
2 | 2 | 58.823
( | / | ) | 0.034
v | m | s
v | cm | cm | s

us

v cm | us | cm | us

k
v cm us

=
= | =

=

= | =
= | = | =

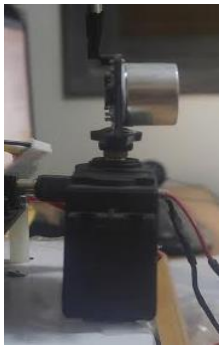
[picture p50: figure]
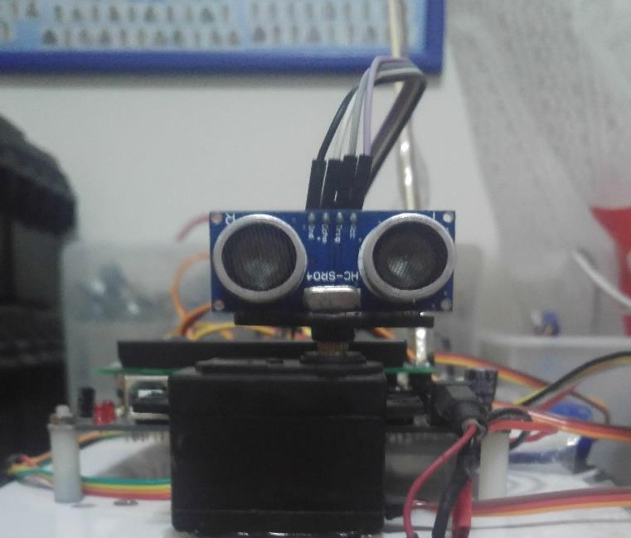
[picture p51: figure]

כמו שאפשר לראות בתמונות למעלה חיישן המרחק שלנו יושב על מנוע הסרבו, כאשר החיישן פונה קדימה )כיוון הרכב( הוא נמצא בזווית 0 של גיר המנוע, לפי נתוני היצרן ניתן לסובב את הגיר המנוע 120 מעלות,כאשר אנו צריכים במקרה שלנו רק 90 מעלות כדי לגרום לחיישן לדגום את המרחק משמאל הרכב, ובכך נדע איפה יש יציאה מהחדר המרובע שבנינו לו, כך הוא מקבל פיידבאק מהעולם החיצון ובעזרת הנתונים הללו הוא מקבל החלטות האם להמשיך ליסוע קדימה או לפנות שמאלה או האם הוא הגיע לפינה ועליו לבצע פניה ימינה ולהמשיך ליסוע לאורך הקיר.

### 1.1.2 ממיר מסוג STEPDOWN7

אנו מחברים את הכניסה של ממיר זה לנקודה שבה יוצא מתח גם למנועי ה DC ומורידים את המתח לאיזור ה V6 בכדי לעבוד עם מנועי ה SERVO. היציאות של ממיר זה מתחברות להדקי ה VCC של ארבעת מנועי ה SERVO בפרויקט.

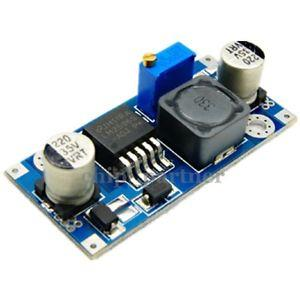
[picture p52: figure]

7PL-IRM0101 1.1.3

המעגל המתואר משמש לקליטת מידע מהמשדר( שלט).

מעגל זה מכיל רכיב 0101-3IRM-PL הממיר מידע מ IR -

לאות דיגיטלי בתחום תדרים.KHz 46 - 36 בפרויקט זה אנו

משדרים למקלט אות בתדר KHz.38

בנוסף המעגל מכיל קבל ונגד לפי דרישות היצרן.

את היציאה מהמשדר יש לחבר להדק במיקרו-בקר. בפרויקט זה הדק המוצא Vout של הרכיב

מחובר להדק 3.7 PORT של המיקרו-בקר, על מנת לגלות את האות המשודר מהשלט-משדר ה

IR ולשלוט במכשירים הביתיים.

המידע שמתקבל במודול IR שודר לפי פרוטוקל IR( 80 – RECS – מוסבר בהמשך בפרק פרוטוקלים(.

U3

PL-IRM0101Vout

1

GND

2

Vcc

3

VCC

220

10uF

P3_7

### 2.2.8 מנוע SERVO:

מנוע ה SERVO כולל בתוכו מנוע DC אך עם מערכת בקרה על זווית סיבוב הגיר של המנוע כאשר הוא מוגבל לזווית של 120 מעלות מקסימום.

מנוע זה כולל 3 הדקים בשונה ממנוע ה DC הרגיל להלן ההדקים והסבר עליהם:

•GND – הדק האדמה.

•VCC- הדק המתח VCC עבור המנוע.

•SIGNAL- להדק זה אנו שולחים את האותות PWM על מנת לשלוט על הזווית שלו.

להלן דוגמא לאות ה PWM שהיצרן דורש בכדי לשלות על זווית הגיר של מנוע ה SERVO:

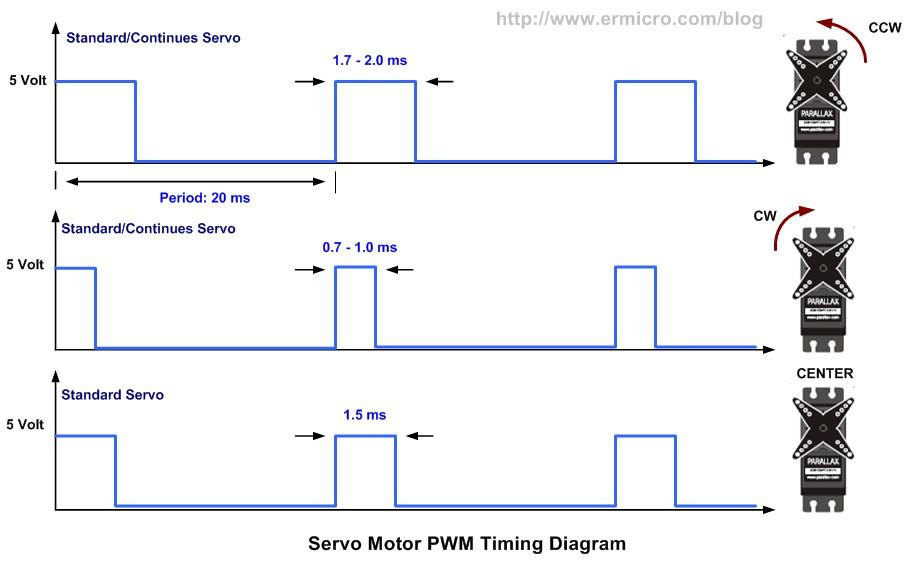
[picture p53: figure]

כפי שאפשר לראות אנו שולטים על זווית גיר המנוע על ידי שינוי של זמן ה C.D של האות כאשר הוא נע בין ms-2ms,1 בתחום הזה אפשר לשלוט על זווית גיר המנוע בין 0-120 מעלות במנועים בפרויקט שלנו, יש מנועי סרבו שמציעים טווח רחב יותר של זוויות או טווחים קטנים יותר, C.D של ms2 יזיז את גיר המנוע לזווית המקסימלית 120 מעלות.

הבקר שלנו 2RD51V89P מסוגל להוציא PWM מ 5 הדקים 1.7P1.3-P כאשר אנו השתמשנו רק ב ,4 1.7P1.4-P, על מנת ליצור אות זה אנו צריכים להשתמש במונה ה PCA של הבקר Array Counter Programmable ויש להגדיר את האוגרים שלו ואת תצורת המנייה שלו, להלן הסבר שכולל חלקים מהתוכנית הראשית כיצד יצרנו את האות PWM המתאים עבור המנועים.

אוגר בקרת ה- PCA:

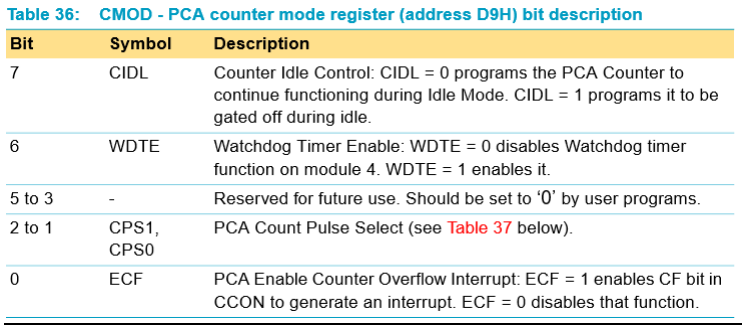
[picture p54: figure]

כאשר אותנו מעניין רק תצורת המנייה של ה-PCA נשנה את ה סיביות 0CPS1-CPS בכדי לבחור פולס מנייה מתאים מתוך ארבעת האופציות שהיצרן מציעה להלן האפשרויות והפקודה בכדי לבחור את המצב:

CMOD=4;

בחרנו להשתמש באופציה ה שלישית שהיא גלישת טיימר ,0 בחרנו להשתמש באופציה זו בגלל שאפשר לקבוע את טיימר אפס בתצורת מנייה של bit8 טעינה אוטומטית, הטיימר מונה מ ערך מסויים שבהמשך נחשב וכאשר הוא מגיע לערך המקסימלי עבור bit8 שזה FF, אוטומטית ברקע התוכנית הראשית אוגר ה TL נטענן עם הערך של אוגר ה TH של מונה זה, זאת אומרת שאפשר להתחיל את המנייה כל הזמן מחדש ברקע לתוכנית הראשית ולכן בחרנו באופציה זו.

בכדי להגדיר את הטיימר בתצורה זו כתבנו את הפקודה הבאה12:x0=TMOD פקודה זו תגדיר את טיימר 0 בתצורת bit8 טעינה אוטומטית ובנוסף תגדיר את טיימר 1 בתצורת 16 ביט ללא טעינה אוטומטית, השתמשנו בטיימר 1 עבור קליטת נתונים ממקלט ה IR.

כיצד ה PCA עובד?

PCA יכול להיות מונה/ טיימר, ואנו בחרנו לעבוד איתו לשם יצירת PWM כאשר אנו עובדים איתו לשם PWM הוא הופך ל bit8 ואת זה אנו מבצעים על ידי אפשור ה PWM עבור הדקי הבקר שרשומים מעלה, להלן אוגר הבקרה אשר אחרי לאפשור ה PWM עבור הדקים אלו )1.7P1.3-P ) כאשר יש אוגר בקרה כזה לכל הדק בנפרד.

להלן האוגר ואיזה ערך נתנו לו בכדי לאפשר לו להוציא אות PWM, בנוסף לכך כחלק מתהליך יצירת האות אפשרנו את פעולת המשווה בין אוגר ה PCA לבין אוגר ה CCAPL שהוא אוגר נפרד לכל פורט.

1. CCAPM1=0x42;
2. CCAPM2=0x42;
3. CCAPM3=0x42;
4. CCAPM4=0x42;

לאחר רצף פקודות אלו אפשרנו את פעולת ה PWM עבור ההדקים 1.7P1.4-P ואת פעולת המשווה בין אוגר ה CCAPL שהוא נפרד לכל הדק לבין אוגר ה CL שהוא אוגר ה PCA שהוא משותף לכל ההדקים.

לאחר בחירה של פולס מנייה מתאים בעזרת CMOD, שבמקרה שלנו כל גלישה של טיימר 0 מונה ה PCA יתקדם ב1 כאשר הערך המקסימלי שאליו הוא יגיעה בסוף המנייה הוא FF.

נשאלת השאלה כיצד אנו ניצור אות PWM בתדר hz50 לפי דרישות היצרן עבור מנועי הסרבו ולהלן החישובים שעשינו בכדי לתת ערכים מתאימים לאוגרי הטיימר 0 ואוגרי ה CCAPH של כל הדק )CCAPH נטענן ל CCAPL בכל גלישת אוגר ה CL, זה קורה בכדי שלא יהיו הפרעות, בעצם המתכנת מעדכן את CCAPH וCCAPL נשאר קבוע ומתעדכן אך ורק בכל גלישה של אוגר ה CL.)

תחילה נחשב את זמן המחזור T:

1
20
50
T | ms
hz

לאחר מכן אנו מסתכלים על טיימר 0 ומבינים

= =

שהגדרנו אותו בתצורת bit,8 זאת אומרת שהערך המקסימלי שהוא יוכל למנות הוא 255 ולכן נבצע

את הפעולה הבאה:

20 | 78
0( | 0 | )
| ms
us
TIMER TL MAX

, זאת אומרת שכל

TL MAX 0 | 255 =
כאשר

=

us78 צריכה להיות גלישת טיימר 0 הטיימר שלנו עובד בקצב הזמן מכונה של הבקר שהינו us,1.085

זאת אומרת שהטיימר שלנו ימנה 255 פולסי זמן מכונה של הבקר זאת אומרת us1.085*255 שיוצא

us276 כאשר אנו צריכים לקבל גלישה רק אחרי us78 ולכן אנו נצטרך להתחל את אוגרי הטיימר

בערך שונה מ 0 בכדי לקבל את הזמן הזה ולכן :

78 | 71( | ) 49( | )
1
us | dec | hex
tmachine

כאשר

= | =

, אז נבצע פעולת חיסור בין הערך המקסימלי של האוגר לבין הערך 49)HEX)

tmachine | us =1.085

, זאת אומרת את הערך 8B נצטרך לתת לאוגרי ה 0TH ו ה 0TL
FF hex | hex | B ( | ) 49( | ) | 8 - | =
ולכן
בתחילת התוכנית כדי לקבל גלישת טיימר כל us.78

אם כל us78 מתבצעת קידום של אוגר ה CL ב 1 אפשר לומר: ואנו רואים שבאמת נוצר
CL MAX ( ) 255 =

כאשר
78 * | ( | ) 19.89 | 20 us CL MAX | ms | ms = | →
אות בזמן מחזור של ms20 שהינו תדר של hz.50

להלן קוד בתחילת התוכנית כדי לתת לאוגרי ה טיימר ערכים מתאימים כפי שחישבנו :

1. TH0=0xB8;
2. TL0=0xB8;

3. TR0=1;

1=0TR בכדי להפעיל את פעולת הטיימר של טיימר ,0 להלן איור שמתאר את שינוי הלוגי של כל ההדקים שאפשרו להם פעולת PWM כתלות באוגר ה PCA - CL.

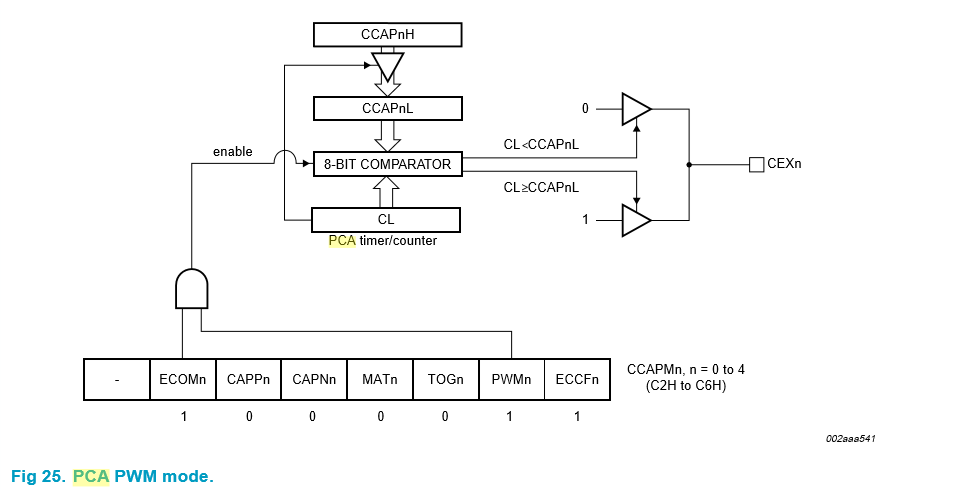
[picture p55: figure]

*חשוב לציין שאיור זה מתאים עבור כל הדק שאליו אנו עובדים עם PWM.

אוגר ה CL מתחיל את המנייה שלו מערך 0 עד ערך מקסימלי של FF ובכדי לשנות את ה C.D של אותו הדק נצטרך לשנות את ערך אוגר ה CCAPL כאשר לכל הדק יש אוגר כזה נפרד, את השינוי אנו לא עושים ישירות, זאת אומרת שאנו משנים את CCAPH ו CCAPL נטענן לערך CCAPH אך ורק אחרי גלישת אוגר ה CL( כאשר CL הגיעה ל FF ואז התבצעה עוד מנייה זאת אומרת הוא יתאפס ל 0 (

כעט נסביר איך מתבצעת שינוי ב C.D של האות ה PWM בעזרת שינוי של אוגר ה CCAPL.

כפי שניתן לראות באיור ההדק של הפורט שאיתו אנו עובדים בPWM יהיה ב רמה לוגיית נמוכה – ‘0’ כאשר אוגר ה CL קטן בערכו מאוגר ה CCAPL, ו יהיה ברמה לוגית גבוהה כאשר CL יהיה גדול בערכו מאוגר ה CCAPL. כעט נחשב איזה ערך צריך לתת לאוגר ה CCAPL בכדי לקבל C.D של ms1 עבור האות שהוא כולו ms20 – hz50 כפי שהיצרן דורש.

אנו יודעים שרק אחרי גלישת טיימר 0 שזה כל us78 אוגר ה CL יתקדם ב .1 ולכן בכדי לקבל רמה לוגית גבוהה – ‘1’ לוגי במוצא ההדק למשך זמן של ms1 עבור האות שכולו ms20 לפי נתוני היצרן אות כזה ברגל ה SIGNAL של המנוע תזיז את גיר המנוע לזווית ה 0 כפי שניתן לראות בגרף שצורף בתחילת ההסבר על מנועי הסרבו, להלן החישוב :

( | (max) | )*78 | 1
(max) 255
20 | 78 | 1
78 | 19
| 243.58 | 244
CL | X | us | ms
CL
m | uX | ms
uX | m
X
- =
=
- =
=
= | →

לכן נתנו לאוגר CCAPH את הערך 244 בכדי לקבל C.D של ms1 בתדר של hz50 בתחילת התוכנית כמובן שניתן לשנות את אוגר ה CCAPH בכדי לשלות על הזווית כעט נחשב את הערך שצריך לתת לאוגר זה בכדי להגיע לזווית המקסימלית של המנוע שהינה 120 מעלות, ה C.D הדרוש עבור זווית זו הוא ms2 להלן החישוב:

( | (max) | )*78 | 2
(max) 255
20 | 78 | 2
78 | 18
18 | 230
78
CL | X | us | ms
CL
m | uX | ms
uX | ms
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
לאחר החישובים הללו אנו מבינים שערך של אוגרי ה CCAPL עבור כל הדק שהגדרנו לשימוש מנועי סרבו ינוע בין 244-230 כאשר 244 היא הזווית ה 0 ו 230 היא הזווית המקסימלית 120 מעלות.

לאחר כל ההגדרות והחישובים שביצענו בכדי ליצור את האות לפי דרישות היצרן נשאר להפעיל את פעולת המונה של ה PCA להלן האוגר CCON שהינו אוגר הבקרה של מונה זה

נתנו לאוגר זה את הערך 40x0=CCON בכדי להפעיל את פעולת המנייה על ידי שינוי סיבית ה CR כאשר סיבית זו ‘1’ לוגי אז מונה ה PCA יתחיל לעבוד.

# פרק 73

# פרוטוקולים

:IR-RECS-80 | פרוטוקול
- אור אינפרא אדום )תת אדום( הוא קרינה אלקטרומגנטית באורך גל הגדול מזה הנראה בעין.
- אורכי הגל נעים בטווח של 750 ננומטר עד 30,000 ננומטר.
- שימושים בקרינה זו:
מצלמות הרואות ביום ובלילה. תקשורת בין מכשירים.
ועד לחימום.
בפרויקט שלנו אנו משתמשים בפרוטוקול זה על מנת ליצור קשר בין השלט לבין הרכב בכדי שיוכל לבצע את תנועותיו. לבקר מחובר חיישן IR אשר קולט את הנתונים מהשלט וכך יודע לבצע את פעולות הרכב.

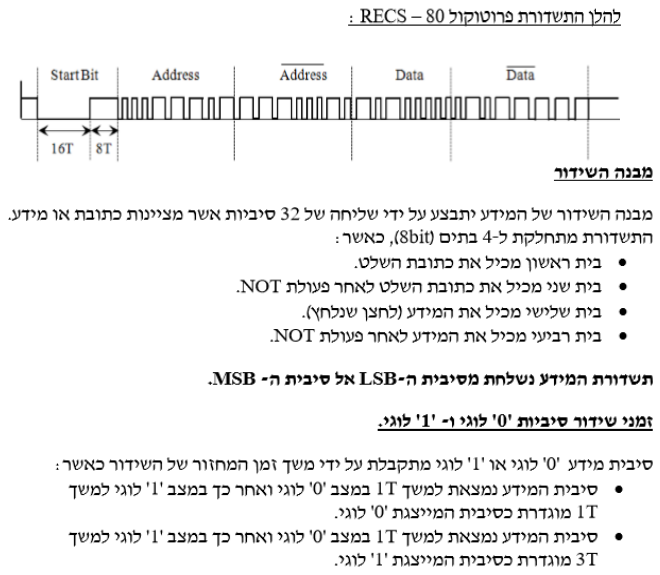
[picture p56: figure]

נשאלת השאלה מדוע השלט משדר את המידע וכתובת השלט פעמיים, פעם אחת רגיל ופעם אחת אחרי פעולת ?NOT דבר זה קורה בכדי לבדוק שהתקשורת אכן אמינה ולא לקלוט שגיאות ובכך לקלוט נתונים שלעולם לא נשלחו באמת, באמצעות הבקר אנחנו עושים פעולת

NOT למידע שנשלח כ NOT ואז אנחנו מקבלים את המידע ומשווים את המידע המקורי למידע שהיתקבל לאחר פעולת NOT על המידע שהיה NOT המידע.

זהיו תקין של הזמנים מתקבל לפי הטבלה הזו אפשר לראות התאמה בין הבדיקה עצמה בשורות הקוד שהוספתי למטה לבין הנתונים בטבלה.

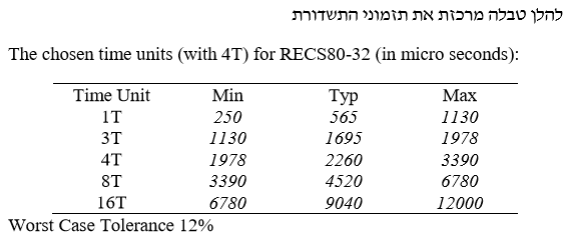
[picture p57: figure]

להלן קטע קוד מתוך הפונקציה ()remote bit אשר מזהה את T16 שהוא חלק מ- START :BIT

1. TL1=TH1=0;
2. TR1=1;
3. while(!bit_IR);//bit_IR up
4. TR1=0; //stop timer
5. time_units =TH1;
6. time_units =time_units <<8;//shift left 8
7. time_units =time_units |TL1; //
8. if(time_units <11060 && time_units >6248)// check 16T
9. {

לאחר זיהוי תקין של פרק זמן של T16 ברמה לוגית נמוכה התוכנית ממשיכה לבדיקת זמן של T8 ברמה לוגית גבוהה כאשר היא מהווה את החלק השני של ה BIT START.

1. TL1=TH1=0;
2. TR1=1;
3. while(bit_IR);//bit_IR down
4. TR1=0; //stop timer
5. time_units =TH1;
6. time_units =time_units <<8;
7. time_units =time_units |TL1;
8. if(time_units <6248 && time_units >3124)
9. {

לאחר זיהו תקין של פרק זמן של T8 ברמה לוגית גבוהה התוכנית סיימה לפענח את ה BIT START וממשיכה לפענוח ה ADDRESS של השלט כאשר הסיבית ‘0’ ו ‘1’ מוגדרות כך:

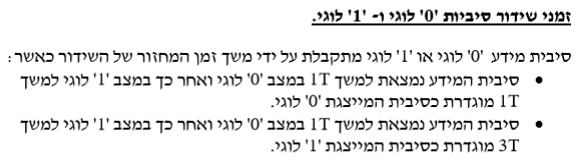
[picture p58: figure]

1. for(len_arr=0;len_arr<4;len_arr++)
2. {
3. num=0;
4. for(num_bit=0;num_bit<8;num_bit++)
5. {//==== 1T =======//
6. while(!bit_IR);//bit_IR up
7. //===== 3T ======//
8. TL1=TH1=0;
9. TR1=1;
10. while(bit_IR); //bit_IR down
11. TR1=0; //stop timer
12. time_units =TH1;
13. time_units =time_units <<8;
14. time_units =time_units |TL1;
15. if(time_units <1823 && time_units >1041)//3t
16. num|=1<<num_bit;
17. }//for8
18. arr_remote[len_arr]=num;
19. }

לולאה זו רצה 4 פעמים כאשר הפעם הריאשונה היא מפענחת את ADDRESS לאחר מכן היא מפענחת את ADDRESS NOT ולאחר מכן DATA ואחרי זה את DATA NOT. לאחר שהיא מסיימת לקבל את ארבעת הבתים הללו היא בודקת האם התקשורת אמינה על ידי פעולת NOT על כתובת שנשלחה כ NOT ועל המידע שנשלח כ NOT בכדי לבצע השווה בין המידע המקורי ולבין המידע שנשלח כ NOT וכך רואים אם התקשורת אכן תקינה, להלן הקטע קוד שאחרי לכך:

1. if(arr_remote[0]==~arr_remote[1]) //address && !address
2. if(arr_remote[2]==~arr_remote[3])
3. return 1;
4. return 0;

אם ADDRESS שווה ל NOT של ADDRESS NOT זאת אומרת אם ADDRESS שווה ל ADDRESS אז אכן יש תקשורת אמינה לאחר מכן הוא מבצע את אותה פעולה על DATA ו

DATA NOT בכדי לבדוק שוב כדי לוודאות שהתקשורת אכן אמינה. אם הבדיקות היו תקינות הפונקציה תחזיר 1 בנוסף לכך בתוך המערך []remote_arr נמצאים הנתונים של ADDRESS ADDRESS NOT DATA DATA NOT בסדר עולה מ 0 עד 3 זאת אומרת שבמקום ה 2 של המערך remote_arr נמצא ה DATA שלנו.

# פרק 71

# תוכנית

### 1.4 תכנית בשפת C

### 1.4.4 תרשים זרימה7

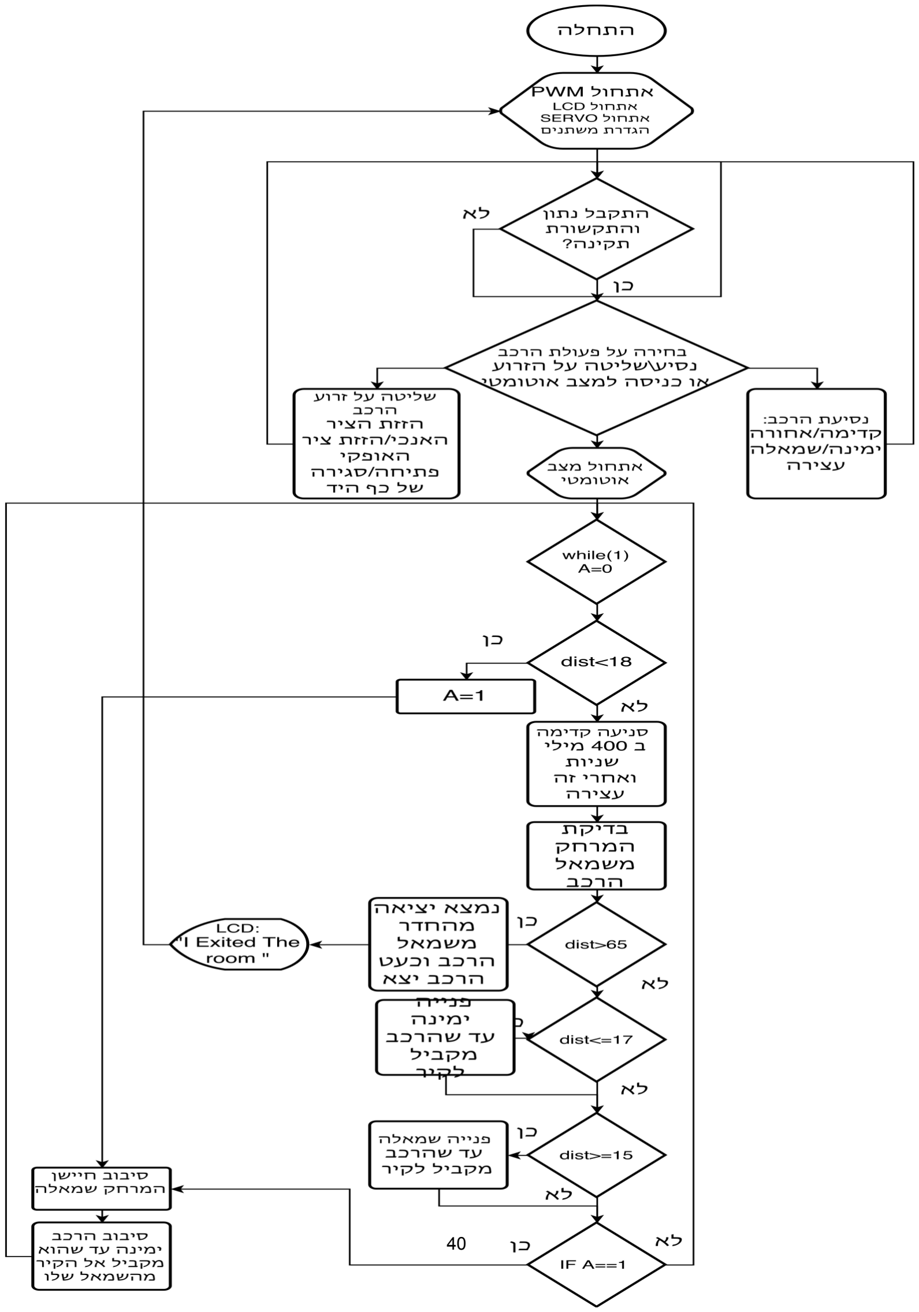
[picture p59: page 40]

### 1.4.1 קבצי h7

General.h

1. // for P89V51RD2
2. #ifndef __general_h__
3. #define __general_h__
4.
5. typedef unsigned char byte;
6. typedef unsigned int uint; 7.
8. #define ACK 0
9. #define NACK 1
10. #define TRUE 1
11. #define FALSE 0
12. //================= IR CODES DEFINED =============== ==============
13. #define _0 22
14. #define _1 12
15. #define _2 24
16. #define _3 94
17. #define _4 8
18. #define _5 28
19. #define _6 90
20. #define _7 66
21. #define _8 82
22. #define _9 74
23. #define _plus 64
24. #define _minus 25
25. #define _play 21
26. #define _right 9
27. #define _left 7
28. #define _test 68
29. #define _spin 67
30. #define _menu 71
31. #define _shutdown 69
32. //=============================== end ir codes defin e===============================
33.
34.
35. void msec(uint ms);
36. void nop(void);
37.
38.
39. void nop(void){ } // delay 5usec 40.
41.
42. void msec(uint ms)
43. {

44. uint n;
45. uint i;
46. //ms=ms*4.11;
47.
48. for (n=0; n<ms; n++)
49. {
50. for (i=0; i<112; i++);
51. }
52. }
53.
54. void usec(uint us)
55. {
56. while(us--) nop();
57. }
58. #endif

Lcdp2.h

1. //======================================================= ====================
2. // | "lcdp2.h"
3. //======================================================= ====================
4. #ifndef __lcd_4_h__
5. #define __lcd_4_h__
6.
7. #define RS_lcd | P2_0
8. #define RW_lcd | P2_1
9. #define E_lcd | P2_2
10. | #define DATA_lcd | P2
11.
12. //================================================== =========================
13. void set_lcd1(bit char_command,byte lcd_d)
14. {
15. RW_lcd = 0 ;
16. E_lcd = 0 ;
17. RS_lcd = char_command ;
18. DATA_lcd &= 0x87;
19. DATA_lcd |= ((lcd_d &0xf0 )>>1);
20. E_lcd = 1 ;
21. nop();
22. E_lcd = 0 ;
23. msec(3);
24. }
25.
26. void set_lcd(bit char_command,byte lcd_d)
27. {
28. RW_lcd = 0 ;

29. E_lcd = 1 ;
30. RS_lcd =char_command ;
31. DATA_lcd &= 0x87;
32. DATA_lcd |= ((lcd_d &0xf0 )>>1);//write 4bit High
33. E_lcd = 1 ;
34. nop();
35. E_lcd = 0 ;
36.
37.
38. RW_lcd = 0 ;
39. E_lcd = 1 ;
40. RS_lcd = char_command ;
41. DATA_lcd &= 0x87;
42. DATA_lcd |= ((lcd_d &0x0f )<<3);//write 4bit Low
43. E_lcd = 1 ;
44. nop();
45. E_lcd = 0 ;
46. msec(3);
47.
48.
49. }
50.
51.
52. //================================================== =========================
53. /*
54. I/D -
when high, cursor moves right DDRAM addr. inc. by 1
55. -
when low, cursor moves left DDRAM addr. dec. by 1
56. SH - Shift of entire display
57. | D | -
Display on/off (high = on; low = off; Data stored)
58. | C | -
Cursor on/off (high = on; low = off; ID | stored)
59. | B | -
Cursor blink on/off (high = blink on; low = blink off)
60. S/C - 1 - display; 0 - cursor;
61. | R/L - 1 - right; | 0 - left;
62. DL - Interface data length ( 1 - 8 bit; 0 -
4 bit;)
63. | N | - Display line number (1 - two lines; 0 -
one line;)
64. | F | - Display font type (1 - 5x11; 0 - 5x8;)
65. */
66. //================================================== =========================

67. void init_lcd()
68. {
69.
70. msec(50); // Recovery time after power on 71.
72. | set_lcd1(0,0x30);// 0 0 1 DL N F 0 0 | -
FUNCTION SET - 8bit interface
73. | set_lcd1(0,0x30);// 0 0 1 DL N F 0 0 | -
FUNCTION SET - 8bit interface
74. | set_lcd1(0,0x30);// 0 0 1 DL N F 0 0 | -
FUNCTION SET - 8bit interface
75. | set_lcd1(0,0x2C);// 0 0 1 DL N F 0 0 | -
FUNCTION SET - 4bit interface
76.
77. | set_lcd(0,0x2C);// 0 0 1 DL N F 0 0 | -
FUNCTION SET - 4bit interface
78.
79. | set_lcd(0,0x0c);// 0 0 0 0 1 D C B | -
DISPLAY ON/OFF CONTROL
80.
81. set_lcd(0,0x06);// 0 0 0 0 0 1 I/D SH -ENTRY MODE SET
82.
83. set_lcd(0,0x14);// 0 0 0 1 S/C R/L 0 0 -CURSOR OR DISPLAY SHIFT
84.
85. | set_lcd(0,0x01);// 0 0 0 0 0 0 0 1 | -
DISPLAY CLEAR
86.
87. }//init_lcd()
88.
89. void lcd_puts(byte location,const byte *str)
90. {
91. set_lcd(0,location);
92. while(*str) set_lcd(1,*str++);
93. } //lcd_put_str(byte location,const byte *str)
94. void lcd_clr() {
95. set_lcd(0,0x01);
96. }
97. #endif
98.
99.
100. //================================================== =========================
101. | // | End Of File "lcd_p2.h"
102. //================================================== =========================

REG89C51.h

1. //======================================================= ====================
2. // | "REG89C51.h"
3. //======================================================= ====================
4.
5. #ifndef __REG_89C51_H__
6. #define __REG_89C51_H__
7.
8. /* interrupts vectors */
9. #define EXT0_INTERRUPT 0
10. #define TIMER0_INTERRUPT 1
11. | #define EXT1_INTERRUPT | 2
12. #define TIMER1_INTERRUPT 3
13. #define SERIAL0_INTERRUPT 4
14. #define TIMER2_INTERRUPT 5
15. | #define PCA_INTERRUPT | 6
16. #define SERIAL1_INTERRUPT 7
17. | #define EXT2_INTERRUPT | 8
18. | #define EXT3_INTERRUPT | 9
19. | #define EXT4_INTERRUPT | 10
20. | #define EXT5_INTERRUPT | 11
21. | #define WDT_INTERRUPT | 12
22.
23. /* BYTE Register */
24. | sfr CKCON | = 0x8F;
25. | sfr B | = 0xF0;
26. | sfr SP | = 0x81;
27. | sfr DPL | = 0x82;
28. | sfr DPH | = 0x83;
29. | sfr TMOD | = 0x89;
30. | sfr TL0 | = 0x8A;
31. | sfr TL1 | = 0x8B;
32. | sfr TH0 | = 0x8C;
33. | sfr TH1 | = 0x8D;
34. | sfr IP | = 0xB8;
35. | sfr ICON | = 0xFF;
36. | sfr CKSEL | = 0x85;
37. sfr OSCCON = 0x86;
38. | sfr FCON | = 0xD1;
39. | sfr EECON | = 0xD2;
40. | sfr EETIM | = 0xD3;
41.

42.
43. /* PORT

0 */
44. sfr P0

= 0x80;
45. sbit P0_7

= P0^7;
46. sbit P0_6

= P0^6;
47. sbit P0_5

= P0^5;
48. sbit P0_4

= P0^4;
49. sbit P0_3

= P0^3;
50. sbit P0_2

= P0^2;
51. sbit P0_1

= P0^1;
52. sbit P0_0

= P0^0;
53.
54. /* PORT

1 */
55. sfr P1

= 0x90;
56. sbit P1_7

= P1^7;
57. sbit P1_6

= P1^6;
58. sbit P1_5

= P1^5;
59. sbit P1_4

= P1^4;
60. sbit P1_3

= P1^3;
61. sbit P1_2

= P1^2;
62. sbit P1_1

= P1^1;
63. sbit P1_0

= P1^0

;
64.
65. sbit CEX4

= P1^7;
66. sbit CEX3

= P1^6;
67. sbit CEX2

= P1^5;
68. sbit CEX1

= P1^4;
69. sbit CEX0

= P1^3;
70. sbit ECI

= P1^2;
71. sbit T2EX

= P1^1;
72. sbit T2

= P1^0;
73.
74. /* PORT

2 */
75. sfr P2

= 0xA0;
76. sbit P2_7

= P2^7;
77. sbit P2_6

= P2^6;
78. sbit P2_5

= P2^5;
79. sbit P2_4

= P2^4;
80. sbit P2_3

= P2^3;
81. sbit P2_2

= P2^2;
82. sbit P2_1

= P2^1;
83. sbit P2_0

= P2^0;
84.
85. /* PORT

3 */
86. sfr P3

= 0xB0;
87. sbit P3_7

= P3^7;
88. sbit P3_6

= P3^6;
89. sbit P3_5

= P3^5;
90. sbit P3_4

= P3^4;

91. sbit P3_3 = P3^3;
92. sbit P3_2 = P3^2;
93. sbit P3_1 = P3^1;
94. sbit P3_0 = P3^0;
95.
96. | sbit RD | = P3^7;
97. | sbit WR | = P3^6;
98. | sbit T1 | = P3^5;
99. | sbit T0 | = P3^4;
100. sbit INT1 = P3^3;
101. sbit INT0 = P3^2;
102. sbit TXD = P3^1;
103. sbit RXD = P3^0;
104.
105. /* PORT 4 */
106. | sfr P4 | = 0xC0;
107. sbit P4_7 = P4^7;
108. sbit P4_6 = P4^6;
109. sbit P4_5 = P4^5;
110. sbit P4_4 = P4^4;
111. sbit P4_3 = P4^3;
112. sbit P4_2 = P4^2;
113. sbit P4_1 = P4^1;
114. sbit P4_0 = P4^0;
115.
116. /* PORT 5 */
117. | sfr P5 | = 0xE8;
118. sbit P5_7 = P5^7;
119. sbit P5_6 = P5^6;
120. sbit P5_5 = P5^5;
121. sbit P5_4 = P5^4;
122. sbit P5_3 = P5^3;
123. sbit P5_2 = P5^2;
124. sbit P5_1 = P5^1;
125. sbit P5_0 = P5^0;
126.
127.
128. /* ACC */
129. | sfr | ACC | = | 0xE0;
130. | sbit ACC_7 | = | ACC^7;
131. | sbit ACC_6 | = | ACC^6;
132. | sbit ACC_5 | = | ACC^5;
133. | sbit ACC_4 | = | ACC^4;
134. | sbit ACC_3 | = | ACC^3;
135. | sbit ACC_2 | = | ACC^2;
136. | sbit ACC_1 | = | ACC^1;
137. | sbit ACC_0 | = | ACC^0;
138.
139. /* PCON */

140. sfr PCON = 0x87;
141. sbit SMOD = 0x8E;
142. sbit SMOD1 = 0x8E;
143. sbit SMOD0 = 0x8D;
144. | sbit POF | = 0x8B;
145. | sbit GF1 | = 0x8A;
146. | sbit GF0 | = 0x89;
147. | sbit PD | = 0x88;
148. | sbit IDL | = 0x87;
149.
150.
151. /* TCON */
152. | sfr TCON | = | 0x88;
153. | sbit TF1 | = | TCON^7;
154. | sbit TR1 | = | TCON^6;
155. | sbit TF0 | = | TCON^5;
156. | sbit TR0 | = | TCON^4;
157. | sbit IE1_ | = | TCON^3;
158. | sbit IT1 | = | TCON^2;
159. | sbit IE0_ | = | TCON^1;
160. | sbit IT0 | = | TCON^0;
161.
162.
163. | /* | SCON | */
164. | sfr | SCON_1 = | 0xC0;
165. | sfr | SCON | = | 0x98;
166. | sbit SM0 | = | SCON^7;
167. | sbit FE | = | SCON^7;
168. | sbit SM1 | = | SCON^6;
169. | sbit SM2 | = | SCON^5;
170. | sbit REN | = | SCON^4;
171. | sbit TB8 | = | SCON^3;
172. | sbit RB8 | = | SCON^2;
173. | sbit TI | = | SCON^1;
174. | sbit RI | = | SCON^0;
175.
176. | sfr | SBUF_1 = | 0xC1;
177. | sfr | SBUF | = | 0x99;
178.
179. | sfr BRL | = | 0x9A;
180.
181.
182. | sfr WDTRST = | 0xA6;
183. | sfr WDTPRG = | 0xA7;
184.
185. | sfr AUXR1 | = | 0xA2;
186.
187. | /* | IE | */
188. | sfr | IE | = | 0xA8;

189. | sfr | IE0 | = | 0xA8;
190. | sbit EA | = | IE^7;
191. | sbit EC | = | IE^6;
192. | sbit ET2 | = | IE^5;
193. | sbit ES | = | IE^4;
194. | sbit ET1 | = | IE^3;
195. | sbit EX1 | = | IE^2;
196. | sbit ET0 | = | IE^1;
197. | sbit EX0 | = | IE^0;
198.
199. | sfr SADDR | = | 0xA9;
200.
201.
202. | sfr SADDR_1 = | 0xAA;
203.
204.
205.
206. | sfr AUXR | = | 0x8E;
207.
208. | sfr SADEN | = | 0xB9;
209.
210. | sfr SADEN_1 = | 0xBA;
211.
212. | sfr IPH | = | 0xB7;
213. | sfr IPH0 | = | 0xB7;
214.
215. | sfr IPL | = | 0xB8;
216. | sfr IPL0 | = | 0xB8;
217.
218. sbit PPC = IPL^6;
219. sbit PT2 = IPL^5;
220. | sbit PS | = IPL^4;
221. sbit PT1 = IPL^3;
222. sbit PX1 = IPL^2;
223. sbit PT0 = IPL^1;
224. sbit PX0 = IPL^0;
225.
226.
227. | /* | T2CON | */
228. | sfr | T2CON = | 0xC8;
229. | sbit TF2 | = | T2CON^7;
230. | sbit EXF2 | = | T2CON^6;
231. | sbit RCLK | = | T2CON^5;
232. | sbit TCLK | = | T2CON^4;
233. | sbit EXEN2 = | T2CON^3;
234. | sbit TR2 | = | T2CON^2;
235. | sbit CT2 | = | T2CON^1;
236. | sbit CPRL2 = | T2CON^0;
237.

238.
239. | /* T2MOD | */
240. | sfr T2MOD | = | 0xC9;
241. | sfr RCAP2L = | 0xCA;
242. | sfr RCAP2H = | 0xCB;
243. | sfr TL2 | = | 0xCC;
244. | sfr TH2 | = | 0xCD;
245.
246. | sfr BDRCON = | 0x9B;
247.
248. | sfr BDRCON_1 = | 0x9C;
249.
250.
251. | /* | PSW */
252. | sfr PSW | = | 0xD0;
253. | sbit CY | = | PSW^7;
254. | sbit AC | = | PSW^6;
255. | sbit F0 | = | PSW^5;
256. | sbit RS1 | = | PSW^4;
257. | sbit RS0 | = | PSW^3;
258. | sbit OV | = | PSW^2;
259. | sbit UD | = | PSW^1;
260. | sbit P | = | PSW^0;
261.
262.
263. | /* | CCON */
264. | sfr CCON | = | 0xD8;
265. | sbit CF | = | CCON^7;
266. | sbit CR | = | CCON^6;
267. | sbit CCF4 | = | CCON^4;
268. | sbit CCF3 | = | CCON^3;
269. | sbit CCF2 | = | CCON^2;
270. | sbit CCF1 | = | CCON^1;
271. | sbit CCF0 | = | CCON^0;
272.
273.
274. | // | CMOD | //
275. | sfr CMOD | = | 0xD9;
276. | sfr CCAPM0 = | 0xDA;
277. | sfr CCAPM1 = | 0xDB;
278. | sfr CCAPM2 = | 0xDC;
279. | sfr CCAPM3 = | 0xDD;
280. | sfr CCAPM4 = | 0xDE;
281.
282. | sfr CL | = | 0xE9;
283. | sfr CCAP0L = | 0xEA;
284. | sfr CCAP1L = | 0xEB;
285. | sfr CCAP2L = | 0xEC;
286. | sfr CCAP3L = | 0xED;

287. | sfr CCAP4L = | 0xEE;
288.
289. | sfr CH | = | 0xF9;
290. | sfr CCAP0H = | 0xFA;
291. | sfr CCAP1H = | 0xFB;
292. | sfr CCAP2H = | 0xFC;
293. | sfr CCAP3H = | 0xFD;
294. | sfr CCAP4H = | 0xFE;
295.
296.
297. #endif
298. //================================================== =========================
299. | // | | End Of File "REG89C51.h"
300. //================================================== =========================

### 4.1.3 תכנית ראשית 7

1. // wirtten by Yarin Avisidris & Idan Lisha and guided by Ludmila koz
2. #include "REG_89C51.h"
3. #include "general.h"
4. #include "lcdp2.h"
5. #define bit_IR P3_7
6. bit flag=0;
7. sbit trig=P3^6;
8. sbit echo=P3^3; // echo=gate=p3.3
9. byte data arr_remote[4];
10. byte distances[2];
11. uint time,dist;
12. //=================== ULTRASONIC SENSOR INTERRUPTS A ND FUNTIONS================
13. void us_trig() {// trigger function for ultrasonic s ensor
14. trig=1;
15. nop();nop();nop();// delay of 14us requirement s are atleast 10us for sr_04 Trigger
16. trig=0;
17. msec(50);
18. }// end trigger
19. void distance() interrupt 2 { // interrupt function (echo falls int1 interrupt)
20. time =TH1;
21. time =time<<8;//shift left 8
22. time =time|TL1; //
23. dist=time/58;
24. TH1=TL1=0;
25. flag=1;
26. }
27. //======================END OF ULTRASONIC SENSOR INT ERRUPTS AND FUNCTIONS======
28. //====================================REMOTE IR FUNC TION=============================
29.
30. bit remote()
31. {
32. byte data num,num_bit,len_arr;
33. uint data time_units;
34. //=========== 16T =============// 35.
36. TL1=TH1=0;
37. TR1=1;
38. while(!bit_IR);//bit_IR up
39. TR1=0; //stop timer
40. time_units =TH1;

41. time_units =time_units <<8;//shift left 8
42. time_units =time_units |TL1; //
43. if(time_units <11060 && time_units >6248)// chec k 16T
44. {
45. //============= 8T =============//
46. TL1=TH1=0;
47. TR1=1;
48. while(bit_IR);//bit_IR down
49. TR1=0; //stop timer
50. time_units =TH1;
51. time_units =time_units <<8;
52. time_units =time_units |TL1;
53. if(time_units <6248 && time_units >3124)
54. {
55. //========= start of transmitting(DATA) === ======//
56. for(len_arr=0;len_arr<4;len_arr++)
57. {
58. num=0;
59. for(num_bit=0;num_bit<8;num_bit++)
60. {//==== 1T =======//
61. while(!bit_IR);//bit_IR up
62. //===== 3T ======//
63. TL1=TH1=0;
64. TR1=1;
65. while(bit_IR); //bit_IR down
66. TR1=0; //stop timer
67. time_units =TH1;
68. time_units =time_units <<8;
69. time_units =time_units |TL1;
70. if(time_units <1823 && time_u nits >1041)//3t
71. num|=1<<num_bit;
72. }//for8
73. arr_remote[len_arr]=num;
74. }//for4
75. if(arr_remote[0]==~arr_remote[1]) //address && !address
76. if(arr_remote[2]==~arr_remote[3] )
77. return 1;
78. return 0;
79. } // 8t
80. return 0 ;
81. }//16t check
82. return 0;

83. }
84. //====================================== END OF REMO TE FUNCTION================
85. //============================== Start of DC motors functions=====================
86. void forward()
87. {
88. P1_0=0; P1_2=1;
89. P1_1=1; P1_3=0;
90.
91. }
92. void backward() {
93. P1_0=1; P1_2=0;
94. P1_1=0; P1_3=1;
95.
96. }
97. void left() {
98. P1_0=1; P1_2=1;
99. P1_1=0; P1_3=0;
100.
101. }
102. void right() {
103. P1_0=0; P1_2=0;
104. P1_1=1; P1_3=1;
105.
106.
107. }
108. void motorstop() {
109. P1_0=0; P1_2=0;
110. P1_1=0; P1_3=0;
111.
112. }
113. void servo_x(bit control) {
114. if(control==1 & CCAP2H>230 ) CCAP2H--
; // 1 LOGIC AT CONTROL IS ADDIN ANGLE
115. if(control==0 & CCAP2H<244 ) CCAP2H++; // 0 LOGIC AT CONTROL IS SUB ANGLE
116. }
117. void servo_y(bit control) {
118. if(control==1 & CCAP3H>230 ) CCAP3H--
; // 1 LOGIC AT CONTROL IS ADDIN ANGLE
119. if(control==0 & CCAP3H<244 ) CCAP3H++; // 0 LOGIC AT CONTROL IS SUB ANGLE
120. }
121. void servo_init() {
122. CCAP1H=244;
123. CCAP2H=238;
124. CCAP3H=244;
125. CCAP4H=244;

126. }
127. //============================= end of DC Motors fun ctions==========================
128. void main()
129. {
130. bit A=0;
131. byte f;
132. byte prev=10000;
133. init_lcd();
134. servo_init();
135. start:
136. TMOD=0x12;//timer 0 8 bit auto reload pwm for serv o motor, timer1 mode1(ir config)
137. TH0=0xB8;
138. TL0=0xB8;
139. TR0=1;
140. CCAPM1=0x42;
141. CCAPM2=0x42;
142. CCAPM3=0x42;
143. CCAPM4=0x42;
144. CMOD=4;
145. CCON=0x40;
146. while(bit_IR) lcd_puts(0x84,"IR wait");//waiting for steady mode to fall (start of comm)
147. lcd_clr();
148. while(1)
149. {
150. if(remote()){
151. switch(arr_remote[2]) {
152. case _plus: lcd_clr();forward(); break;
153. case _minus: lcd_clr(); backward ();break;
154. case _play: lcd_clr(); motorstop ();break;
155. case _left: lcd_clr(); left();br eak;
156. case _right: lcd_clr(); right(); break;
157. case _6: lcd_clr(); servo_x(1) ; break;
158. case _4: lcd_clr(); servo_x(0); break;
159. case _5: lcd_clr();
160. if(CCAP4H==244) CCAP4H =230; else CCAP4H=244; break; // open/close
161. case _2: lcd_clr(); servo_y(0); break;

162. | case _8: lcd_clr(); servo_y(1); | break;
163. case _spin: if(CCAP1H==244) CCAP1H=234; el se CCAP1H=244; break;
164. | case _test: lcd_clr(); | TMOD=0x
92;//timer 1 int1 interrupt for ultrasonic timer0 8bit au toreload for pwm
165. EX1=1; //enabling interrupt 1
166. TR1=1; // running timer 1, tim er runs when gate is 1.
167. IT1=1; // falling edge inter rupt 1
168. EA=1; // enabling all interr upts
169. TL1=TH1=0;
170. CCAP2H=238; // arm in middle
171. | // | forward();
172. | // | control();
173. | // | while(1) {
174. //
175. | // | us_t
rig();
176. | // | while(!flag);
177. | // | flag=0;
178. // set_lcd(0,0x85);
179. // set_lcd(1,dist/100+0x30);
180. // dist=dist%100;
181. // set_lcd(1,dist/10+0x30);
182. // set_lcd(1,dist%10+0x30);
183. | // | }
184.
185. while(1) {
186.
A=0;
187.
while(A==0) {
188. if(dist<=18) {
189. A=1;
190. motorstop();
191. }
192. if(A==0) {
193. forward();
194. msec(400);
195. motorstop();
196. }
197. us_trig();
198. while(!flag);
199. flag=0;

200. if(dist<=18 & A==0) {
201. lcd_puts(0x84,"B");
202. A=1;
203. }
204.
205.
206. if(A==0) {
207. CCAP1H=234;
208. msec(400);
209. us_trig();
210. while(!flag);
211. flag=0;
212. if(dist>65) {
213. //FINDING EXIT AT LEFT
214. //AND EXITING THE ROOM
215. //FROM THE LEFT
216. forward();
217. msec(1000);
218. left();
219. msec(800);
220. motorstop();
221. forward();
222. msec(3000);
223. motorstop();
224. lcd_puts(0x84,"I exited the room !");
225. goto start;
226. }
227. ///////
228. | /////// | MOVING STR
AIGHT CONTROL
229. ///////
230. ///////
231. if(dist<=17) {
232. right();
233. while(dist<=prev) {
234. us_trig();
235. while(!flag);
236. flag=0;
237. prev=dist;
238. us_trig();
239. while(!flag);
240. flag=0;
241. }
242.
243. }
244. if(dist>=15) {
245. left();

246. while(dist>=prev) {
247. us_trig();
248. while(!flag);
249. flag=0;
250. prev=dist;
251. us_trig();
252. while(!flag);
253. flag=0;
254. }
255.
256. }
257. }
258. //msec(500);
259. CCAP1H=244;
260. msec(100);
261.
262. }
263.
264.
265.
266. ///// this is for EDGE solvi ng when the car needs to rotate right with controll
267. /////
268.
269. if(A==1) {
270. CCAP1H=234;
271. msec(250);
272. }
273. while(A==1 ) {
274. f=0;
275. right();
276. lcd_puts(0x84,"C");
277.
278. while(f<2) {
279. us_trig();
280. while(!flag);
281. flag=0;
282. prev=dist;
283.
284. us_trig();
285. while(!flag);
286. flag=0;
287. if(dist>prev) f++;
288. }
289. CCAP1H=244;
290. A=0;
291. motorstop();
292. }
293. }// end while(1) automatic

294. }
295.
296. }
297. }
298. }

### 1.4.1 הסבר פונקציות

חיישן מרחק 04SR:

פונקצית ה trig_us מייצרת TRIGGER מתאים לרגל ה TRIGGER של החיישן לפי הדרישות יצרן נדרש פולס חיובי ברוחב us10 לפחות כאשר יש רווח של ms50 בין כל פולס, בפרוייקט שלנו נתנו לו us.14

אנו יוצרים את הפולס על ידי פעולה פשוטה של הרמת הדק ה TRIGGER למשך הזמן הנדרש בעזרת Delay.

לחישוב המרחק אנו משתמשים בפונקציה 2 interrupt() distance שהיא פונקצית פסיקה חיצונית 1INT שמתקבלת כאשר הדק ה ECHO של החיישן נופל מ ‘1’ לוגי ל ‘0’ לוגי והתוכנית הראשית מיד קופצת לפונקציה זו כדי לטפל בחישוב המרחק, חשוב לציין שהדק זה לעולם לא יפול מ ‘1’ ל ‘0’ ללא מתן TRIGGER מתאים בעזרת הפונקציה הריאשונה ולכן אנו יודעים שפסיקה עלולה להופיע לאחר הפעלת הפונקציה trig_us

כשרגל ה ECHO של החיישן נמצאת במצב ‘1’ טיימר 1 רץ ומונה את הזמן וכאשר ההדק נופל ל ‘0’ התוכנית הראשית קופצת לפונקציה זו בכדי לחשב את המרחק, הזמן נמצא בתוך האוגרים של הטיימר לאחר חיבור של שתי אוגרי ה 1TH ו ה 1TL בעמצאות פעולת אור לוגי אנו מקבלים את הזמן וניתן לחלק אותו ב 58 בכדי להגיע אל המרחק ב יחידות CM.

חיישן מקלט IR:

לשם קליטת נתונים מהחיישן IR אנו משתמשים בפונקציה ()remote bit פונקציה זו היא פונקציה שמחזירה ערך מסוג BIT זאת אומרת 0 או 1 כאשר 1 מסמל שהתקשורת תקינה והנתונים נשמרו במערך remote_arr ו 0 שהתקשורת לא תקינה.

לפי פרוטוקל -80RECS יש זמנים קבועים עבור הסיביות ‘1’ ו ‘0’ לוגי שאפשר לראות בחלק של פרוטוקולים בספר, בפונקציה אנו מודדים את הזמן שבו המקלט משדר רמה לוגית נמוכה ורמה לוגית גבוהה ובכך מבינים איזה סיבית שודרה ‘0’ או ‘1’ ובכך מפענחים את המידע, לפי פרוטוקול זה נשלחים 4 בתים אל החיישן כאשר הם בסדר הזה ADDRESS, NOT ADDRESS,DATA,DATA NOT. זאת אומרת נשלחים סה"כ 32 סיביות לא כולל BIT START, הפונקציה מבצעת פעולת NOT על המידע שנשלח כ NOT ומשווה אותו עם המידע שנשלח בצורה מקורית ובכך מגיע למסכנה שאכן התקשורת תקינה, ובנוסף הפונקציה ממפה את הבתים הללו במערך remote_arr כאשר הוא מערך של 4 ובתא ה 2 נמצא המידע שלנו שהוא חשוב לנו לצורך שימוש בנתונים שנשלחים.

הפעלת מנועי DC:

לשם הפעלת מנועי ה DC שיש לנו 2 בפרוייקט שעובדים בדומה לתנועה של טנק יש לנו 5 פונקציות, ()motorstop,()right,()left,()backward,()forward כאשר כל פונקציה דואגת

להעלות את ההדקים שמחוברים לדרייבר מנועי ה DC בהתאמה כזו שתצור תנועה מתאימה לדוגמא ()forward תצור פעולה של נסיעה קדימה כאשר היא משנה את הדקי הבקר בצורה הבאה :

1. P1_0=0; P1_2=1;
2. P1_1=1; P1_3=0;

צירוף זה של ההדקים יגרום לנסיעה קדימה, צירוף הפוך של ההדקים יגרום לנסיעה אחרוה

1. P1_0=1; P1_2=0;
2. P1_1=0; P1_3=1;

בדומה ל פונקציות ()right,()left הם דואגות לפניה שמאלה וימינה של הרכב ועובדות בצירופים שונים בדומה לפונקציות קדימה ואחרוה, הפונקציה האחרונה שהיא דואגת לעצירה מלאה של הרכב נקראת ()motorstop וכוללת את הרצף הבא:

1. P1_0=0; P1_2=0;
2. P1_1=0; P1_3=0;

הפעלת מנועי הסרבו:

מנועי הסרבו הם בעצם מנועי DC עם מערכת בקרה אשר מקבלת 2 נתונים, היא מקבלת את מיקום הגיר הנוכחי שנמצא המנוע כרגע ומקבלת PWM אשר מציין לאיזה זווית היא שואפת להגיע, בעזרת המערכת בקרה שנמצאת במנוע הוא יודע שיש שגיאה או סטייה בין המיקום הנוכחי של גיר המנוע ולבין המיקום הסופי שאליו הוא צריך להגיע בכדי שהגיר תיהיה בזווית ה רצויה לפי ה PWM שניתן לו בהדק ה SIGNAL שלו.

בכדי ליצור PWM בבקר זה שהוא כולל PCA לשם יצירת PWM הפעלנו את ה PCAבעזרת הפקודה הבאה 40:x0=CCON;

והגדרנו שההדקים 1.7P1.4-P יהיו הדקים שמוצאים PWM וה PWM יוצא ברקע לתוכנית הראשית, זאת אומרת שהתוכנית הראשית לא מטפלת ביצירת ה PWM עבור המנועים, אותות אלו נוצרים ברקע לתוכנית.

לפי דרישות היצרן של מנוע הסרבו בכדי לשלוט עליו נדרש פולס בתדר hz50 כאשר Ton נע בין ms-2ms1 כאשר ms1 מציין זווית 0 ו ms2 מציין זווית מקסימלית של 120 מעלות את Ton אנו משנים בעזרת שינוי של ערך ה CCAP של ההדק המתאים כאשר 2CCAP הוא בשביל הציר האופקי 3CCAP בשביל הציר האנכי ו 4CCAP בשביל סגירה או פתיחה של כף היד של הזרוע.

להלן דוגמא של איתחול מנועי ה-סברו מהתוכנית הראשית : ()init_servo

1. void servo_init() {
2. CCAP1H=244;
3. CCAP2H=238;
4. CCAP3H=244;
5. CCAP4H=244;
6. }

1CCAP שייך להזזת החיישן מרחק, כפי שניתן לראות לכל ה CCAPH של ההדקים נתנו את הערך 244 שאומר זווית ,0 חוץ מ H2CCAP שניתן לו הערך 238 שאמור להזיז את הציר האנכי של הזרוע למרכז הרכב, זווית 0 למנוע האנכי של הרכב תזיז את הזרוע אנכית בערך 60 מעלות ימינה.

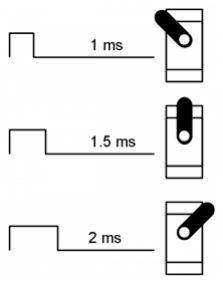
[picture p60: figure]

# פרק 72

# סימולציות

סימולציית PWM ב- Keil7

הסימולציה הבאה מראה אות PWM להדק 1.5P שהוא המנוע האנכי של הזרוע

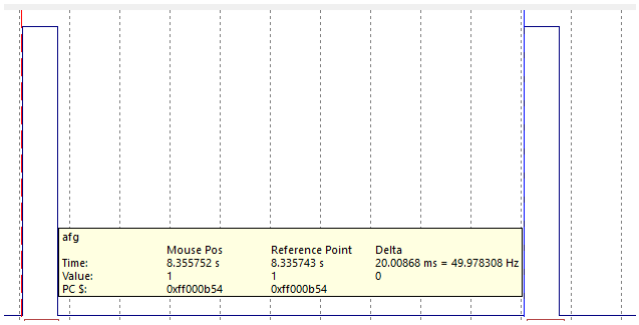
[picture p61: figure]

אפשר לראות שהתדר הואhz50 וגם ניתן לראות שרוחב הפולס הוא ms1.4 שזה נמצא בין ms1 ל ms2 בפונקציה ()init_Servo נתנו פקודה לציר זה לזוז למרכז הרכב אפשר לראות שבאמת ms1.4 נמצא מרכז בין ms1 ל ms2 להלן הגרף :


סימלוציית צירוף לפורט 1 בשביל מנועי ה DC ב- Keil:

עבור הפונקציה ()forward שדואגת לנסיעה קדימה

עבור הפונקציה ()backward שדואגת לנסיעה אחרוה

עבור הפונקציה ()left שדואגת לפניה שמאלה

עבור הפונקציה ()right שדואגת לפניה ימינה

עבור הפונקציה ()motorstop שדואגת לעצירה מלאה של הרכב

הגדרת 0timer בשביל יצירת ה PWM בעזרת PCA

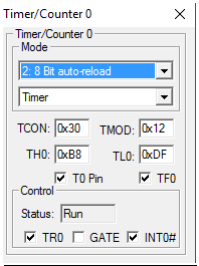
[picture p62: figure]

הגדרת 1timer בשביל קריאת נתונים מהחיישן מקלט IR :

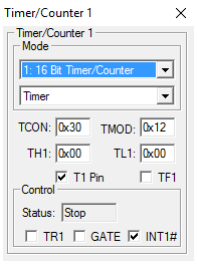
[picture p63: figure]

הגדרת ה PCA בשביל ה PWM :

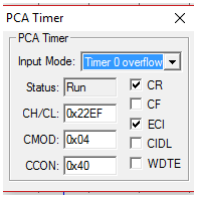
[picture p64: figure]

סימולציה של ה פונקציה ()msec שהיא נמאצת ב h.general אשר יוצרת דיילי באורך זמן של ms1 עבור כל 1 שהיא מקבלת זאת אומרת שהפונקציה תצור דיילי של ms20 אם נרשום ;(20)msec להלן הגרף:


# פרק 73

# סיכום ומסקנות

### 6.1 סיכום ותקלות:

בפרויקט זה בנינו רובוט מכאני עם זרוע אשר נשלט על ידי שלט IR , ויוצא מהחדר באופן אוטומטי.

הרובוט והזרוע מופעלים באופן ידי על ידי השלט מטרת הזרוע היא להרים חפצים מהרצפה , הרובוט מופעל ממנועי DC והזרוע מופעלת ממנועי SERVO . היציאה מהחדר מתבצעת באופן אוטומטי על ידי חיישן אולטרסוני אשר מודד את מרחק הרכב מקיר החדר וכאשר המרחק גדול מהנדרש האו יודע שהוא מצא יציאה.

בפרויקט זה למדנו איך לעבוד עם מנועי SERVO איך ניתן לתפעל אותם לפי זוויות, למדנו איך להשתמש בחיישן האולטרסוני , איך למדוד אתו מרחק ואיך הוא יודע את המרחק בעזרת רגל ה ECHO שיש לו.

שיטת העבודה שלנו בפרויקט הייתה קודם כל לדעת איך פועל כל רכיב או חיישן בנפרד ולאחר מכאן לחבר אותו לפרויקט ולהתחיל לעבוד אתו.

### 6.2 תקלות במהלך הפרויקט:

.1 כאשר חיברנו את ההדק Signal ממנוע הסרבו ישירות להדקי הבקר אז המנוע אינו פעל ולאחר מכן חיברנו דרך החוצץ וכך המנועים פעלו.

# פרק 74

# זיווד

מראה כללי של הרובוט :

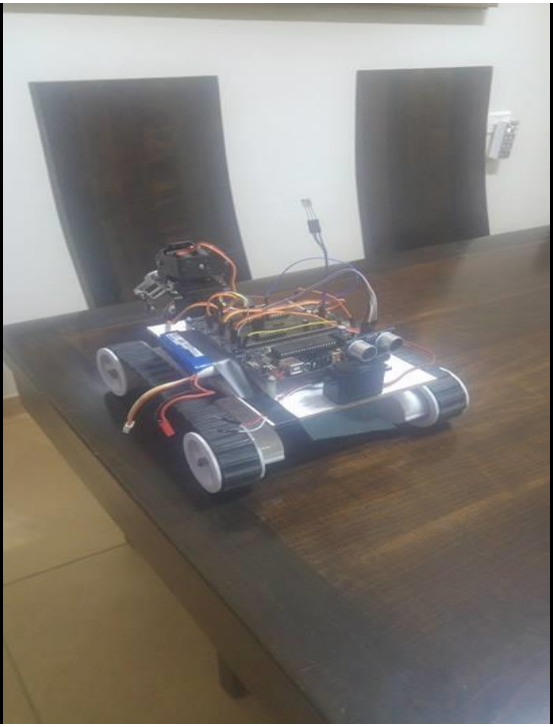
[picture p65: figure]

הזרוע של הרובוט:

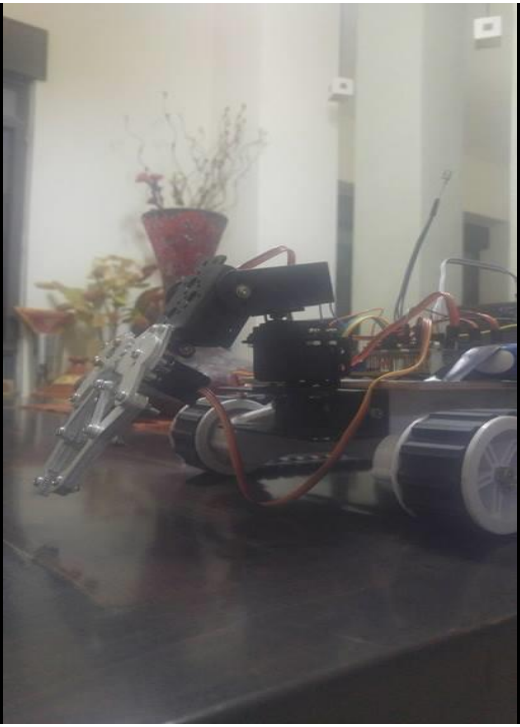
[picture p66: figure]

הקדימה של הרובוט:

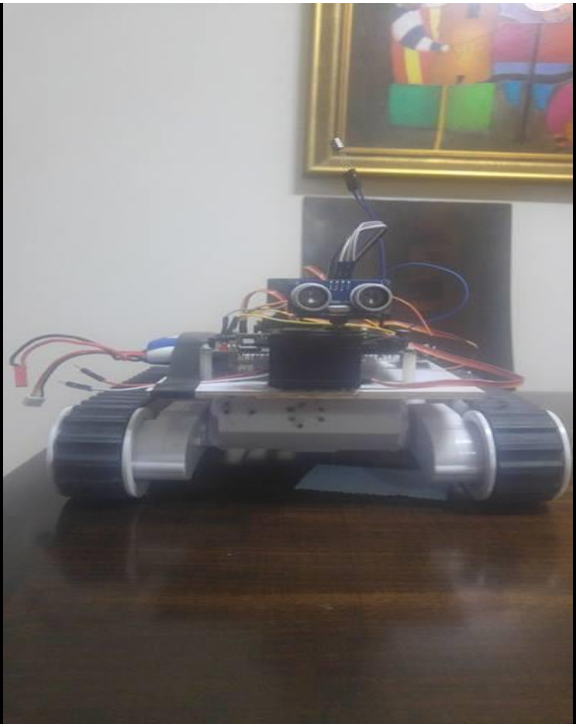
[picture p67: figure]

# פרק 75

# ביבליוגרפיה

אתרים:

http://www.keil.com/dd/docs/datashts/philips/p89v51rd2.pdf

http://wikipedia.org

http://www.micropik.com/PDF/HCSR04.pdf

http://shai.eguru-il.com

# פרק :9

# נספחים

P89V51RD2 | בקר- | מיקרו | 6.4

תכונות:

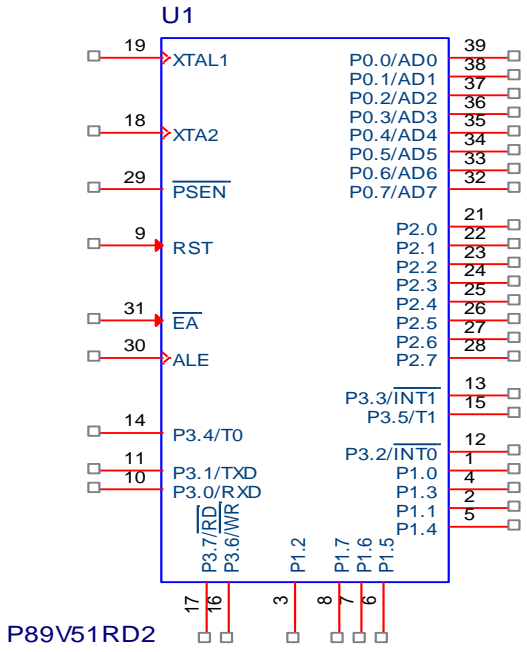
[picture p68: figure]
PSEN; ALE; XTAL1; XTA2; RST; P3.0/RXD; P3.1/TXD; P3.2/INT0; P3.3/INT1

- זיכרון פלאש KB.64
1KB RAM | נתונים | זיכרון | •
- ISP -programing system In – מאפשר לצרוב תכנית למיקרו-בקר מבלי להוציא אותו מן המעגל.
- IAP -programmable application In- ניתן לשנות הגדרות של זיכרון התוכנה פלאש אונליין.
- תדרי עבודה עד MHz.40
- מספק 12 דפקי שעון במחזור מכונה אחת )ברירת מחדל( או ניתן לבחור 6 דפקי שעון למחזור מכונה אחת.
- פרוטוקול תקשורת טורי סינכרוני SPI.
- UART- בקר תקשורת אסינכרונית משופר.

Duty cycle | בקרת | עם | מונים | מערך | -)programmable counter array) –PCA •
(pulse width modulation) - PWM ) | פעולה | מחזור | )
- ארבע שמונה ביט O/I פורטים מהם שלושה הדקים של פורט אחד מספקים זרם גבוה עד mA16 כל אחד.
- שלושה טיימרים בני 16 ביט.
- טיימר watchdog הניתן לתכנות.
- שמונה מקורות פסיקה עם 4 רמות עדיפות.

תיאור הדקים7

RESET – קו זה משמש לאיפוס הרכיב. האיפוס נועד לכוון את המיקרו בקר לבצע את תכנית

ההפעלה שלו החל מכתובת H0000 בזיכרון התוכנית. איפוס הרכיב מתבצע ע"י מתן רמה לוגית

גבוהה "1".

2X 1,X – קווי חיבור הגביש לתזמון הרכיב כאשר תדר העבודה הוא תדר הגביש.

* נחיצות הגביש היא לשם שמירה על תדירות קבועה.

0PORT – קווי קלט/פלט היכולים להתנהג כמפתח דו כיווני ניתן לגשת בתוכנה לכל הדק

בנפרד או לכל המילה בת ה8- סיביות. מפתח זה הוא מפתח מרובב בזמן )AD-0AD7), כלומר על מפתח זה יופיעו גם נתונים וגם כתובות חלק נמוך. 1PORT- מפתח קלט/פלט המשמש לחיבור של אמצעי קלט/פלט שונים כמו לוח מקשים לדוגמא.
2PORT- מפתח זה מהווה את החלק הגבוה של הכתובות )A-8A15),שימושי בעיקר להרחבת הזיכרון.
3PORT- משמש כמפתח קלט/פלט או כמפתח הבקרה והפסיקות ומכיל את ההדקים הבאים:
RXD- הדק לקליטה טורית של נתונים.

TXD- הדק לשידור טורי של נתונים.

0INT 1,INT- הדקי קבלת פסיקה חומרה פעילות או בירידה או ברמה "0".

0T 1,T- הדק להפעלת טיימר, '0' בצורה חיצונית )T0 )והדק להפעלת טיימר '1' בצורה חיצונית

)1T(

'RD-'WR- הדקי בקרת כתיבה או קריאה לזיכרון נתונים חיצוני.

ALE- הדק המבצע את ההפרדה בפורט 0 המרובב בין פס הנתונים לבין פס הכתובות חלק נמוך.

"0"- בהדק זה יעברו הכתובות חלק נמוך למוצא.

"1"- בהדק זה יעברו נתונים מהמיקרו או אל המיקרו.

'PSEN- הדק לציון קריאה מזיכרון תכנית חיצוני. ניתן להתייחס להדק זה כהדק RD/ נוסף במיקרו המשמש לקריאה מזיכרון תכנית חיצוני. 'EA- הדק בקרה לגבי זיכרון תוכנה להדק זה 2 אופציות: כאשר נחבר הדק זה לאדמה תתאפשר עבודה עם זיכרון תוכנה חיצוני. כאשר נחבר הדק זה ל - Vcc תתאפשר עבודה עם זיכרון תוכנה פנימי.

אוגרים ב75524-

IE(Interrupt Enable) : | האוגר
EA | - | - | ES | ET1 | EX1 | ET0 | EX0

EA- ע"י מתן '0' בסיבית זו ממסכים את כל הפסיקות וע"י מתן '1' בסיבית זו יש לנו גישה

לאפשר את הפסיקות השונות.

ES- אפשור /מיסוך פסיקת ה. -UART

1ET- אפשור/מיסוך פסיקת טיימר .1

1EX- אפשור /מיסוך פסיקת 1.INT

0ET- אפשור / מיסוך פסיקת טיימר 0 .

0EX- אפשור/מיסוך פסיקת 0INT.

IP(Interrupt Priority) : | האוגר
- | - | - | PS | PT1 | PX1 | PT0 | PX0

PS- מתן עדיפות לפסיקת UART.

1PT- מתן עדיפות לפסיקת 1TIMER.

1PX- מתן עדיפות לפסיקת 1INT.

0PT- מתן עדיפות לפסיקת 0TIMER.

0PX- מתן עדיפות לפסיקת 0INT.

TCON(Timer Control): | האוגר
TF1 | TR1 | TF0 | TRO | IE1 | IT1 | IE0 | IT0

באוגר זה 8 סיביות בקרה אך רק 4 מאיתן שייכות לאפיוני הטיימר-

1IT / 0IT-' 0 'בסיבית זו תקבע כי תצורת הדרבון תהיה רמה שלילית בפסיקות 1INT0/INT.

'1' בסיבית זו יקבע כי תצורת הדרבון תהיה דרבון קצה שלילי בפסיקות 1INT / 0INT.

1IE0/IE- היתרון הגדול של סיביות אלו הוא בשימוש בתשאול אשר לא מצריך את אפשור

הפסיקה אלא דגימת סיביות אלו.

0TR- כאשר נשים '1' בסיבית זו יתחיל טיימר 0 לרוץ.

1TR- כאשר נשים '1' בסיבית זו יתחיל טיימר 1 לרוץ.

0TF- דגל זה עולה ל-'1' כאשר טיימר 0 מגיע לגלישה.

1TF- דגל זה עולה ל-'1' כאשר טיימר 1 מגיע לגלישה.

TMOD(Timer MODE) : | האוגר
GATE | C\ \T | M1 | M0 | GATE | C\ \T | M1 | M0

אוגר זה מכיל 8 סיביות: 4 ה LSB- מתייחסות לטיימר 0 ו4- ה MSB- לטיימר.1

C/T- אם סיבית זו ב-"0" אז הטיימר משמש כקוצב זמן שסופר עפ"י תדר המתנד של המיקרו זמן מכונה

אחד השווה ל- usec1 .אם סיבית זו ב-"1" הטיימר משמש כמונה אירועים חיצוניים בסיביות 1T0/T

והוא יספור עפ"י דרבוני קצה חיוביים.

0M ו- 1M- סיביות אלו יקבעו באיזה מצב פעולה יעבוד הטיימר-

תיאור המצבים מתואר בטבלה הבאה:

מונה 13 סיביות- בצורת עבודה זו הטיימר מונה בגודל 13 סיביות כלומר כל TL וחמש סיביות מ TH-

כאשר שלושת הסיביות אינן משפיעות.

אופן פעולה זה נוצר כדי ליצור התאמה בין רכיבי 51MCSלרכיבי משפחת 48MCSהאיטיים פי 32

ממשפחת . 51MCS

מונה 16 סיביות- בתצורת עבודה זו הטיימרים מתפקדים הן כטיימרים והן כמונים בעלי 16 סיביות כל

אחד.

מונה 8 סיביות טעינה אוטומטית- משמש בעיקר ליצירת קצב שידור וקליטה ביחידת ה -UART. במצב

זה הטיימר מקדם את TL מהערך שנמצא ב-TH וכאשר מגיע למקסימום הערך שב-TH נכנס בצורה

אוטומטית ל -TL והספירה ממשיכה.

קביעת ה -BAUD- מצב זה נועד לקביעת קצב השידור\קליטה של סיביות ביחידת ה-UART

לצורך פעולתו, דורש ה -UART גל ריבועי מחזורי אשר יקבע את קצב העברת הנתונים.

*אנו נשתמש ב 1TIMER- שיציאתו מחוברת ל UART-כיציאת שעון.

את אופן פעולת ה1-TIMER נקבע למצב של טעינה אוטומטית ונטען לתוכו ערך ראשוני

אשר יקבע על פי הנוסחה הבאה:

תיאור מצב MMO 1MM

00 00 | טיימר 13 סיביות
11 00 | מונה\טיימר 16 סיביות

טעינה אוטומטית
11 | 00
11 11 | מיועד לקביעת BAUD

האוגר – (Control Serial(SCON אוגר בקרת התקשורת הטורית:

תפקיד אוגר זה הוא לקבוע את תצורת העבודה של יחידת התקשורת הטורית.

RI- סיבית המציינת כי אוגר-SBUF מלא וכי נקלטה מילה.

סיבית זו עולה ל-'1' אוטומטית ומציינת פסיקת UART קליטה.

על המתכנת להוריד סיבית זו בתוכנה על מנת לאפשר קליטת בתים נוספים.

TI- מציינת כי אוגר-SBUF ריק ושודר BYTE

סיבית זו עולה ל-'1' אוטומטית ומציינת פסיקת UART שידור.

על המתכנת להוריד סיבית זו בתוכנה על מנת לאפשר שידור בתים נוספים.

8RB- סיבית תשיעית נקלטת, שימושית למטרת בקרת שגיאות.

8TB- סיבית תשיעית משודרת )בדרך כלל שימושית לזוגיות( ערכה נקבע ע"י מערכת התוכנה,

שימושית לבקרת שגיאות.
במערכת רבת מעבדים מאפשרת למקלט לברור את תווי המידע הנקלטים ע"י סיבית זו שתשודר בסיום כל תו.

2SM- סיבית המיועדת לתקשורת רבת מעבדים.

מאפשרת למקלט לברור את תווי המידע הנקלטים ע"י הסיבית התשיעית של כל תו.

כאשר סיבית זו ב-'1' המיקרו יתייחס לתו הנקלט בתנאי שהסיבית התשיעית '1'.

כאשר סיבית זו ב-'0' המיקרו יתייחס לכל תו נקלט ללא התייחסות לסיבית ה.9-

-SM0 , SM1

FOS- תדר הגביש המחובר למיקרו.

SM0 | SM1 | SM2 | REN | TB8 | RB8 | TI | RI
SM0 | SM1 | MODE
0 | 0 | Shift register (fosc/12)

uart bit 8 קצב משתנה 1 0

1 | 0 | 9 bit uart (fosc/64)

uart bit 9 קצב משתנה 1 1

### 6.1 דרייבר דוחף זרם למנוע D293L

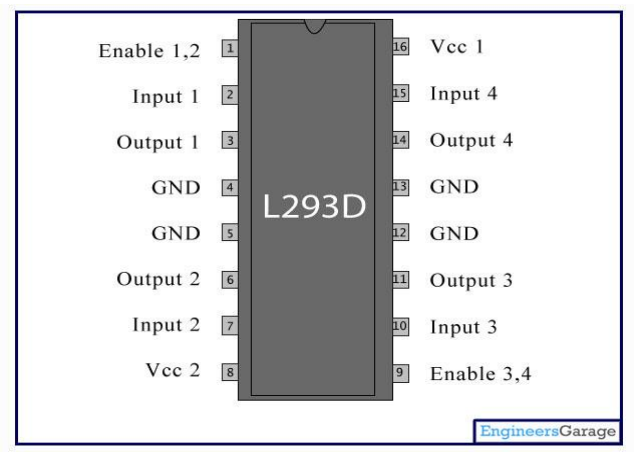
[picture p69: figure]

הדרייבר הוא רכיב דוחף זרם למנועים. דרייבר זה תואם למנועי DC וAC. נשלט ע"י יחידת מיתוג במבואות שלו )כמו מיקרו-בקר(. הדרייבר מהווה " BRIDGE-H"', לכן מאפשר לשנות כיוון סיבובי מנועים ע"י מיתוג הכניסות שלו.

הדרייבר מסוגל לספק עד mA600 ביציאות ומתח בתחומים: V36 to V.4.5 דרייבר זה עובד בצורה של דרייברים כפולים, כלומר 4 יציאות עבור 2 מנועים. הרכיב עובד בשיטת ייצוג מתחים TTL במבואו ומגביר זרם במוצאו ע"י חיבור טרנזיסטורים

כמגברי זרם. במצב כזה – זרם מוצא של קולט )collector )של טרנזיסטור הקודם נכנס להדק

בסיס )BASE )של טרנזיסטור הבא. וכך הלאה בחיבור קסקדה. נוצרת הגברת זרם לפי: ib*b= IC.

הדקים:

- הדקים 1-4IN – כניסות מיתוג לוגי.
- הדקים 1-4 OUT - יציאות רכיב.
- 1,2ENABLE – הדקים לאפשור המוצאים )1,2OUT).
- 3,4 ENABLE- הדקים לאפשור המוצאים )3,4OUT).
- VCC - מתח הספקה .
- 2VCC- מתח מוצא למנועים.
- GND –אדמת רכיב.

BRIDGE-H כולל 4 מפסקים )טרנזיסטורים( שמחוברים בצורת H כאשר המנוע במרכז ה-H.

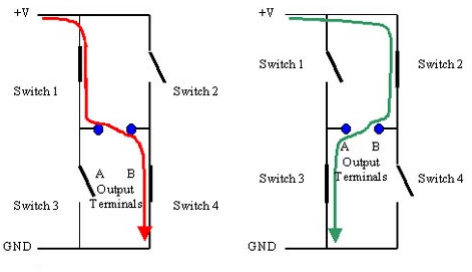
[picture p70: figure]

כשמפסקים 1-4 סגורים A מחובר להדק החיובי ו- B מחובר להדק השלילי

כשמפסקים 2-3 סגורים A מחובר להדק השלילי ו- B מחובר להדק החיובי. כתוצאה מכך המנוע נע בכיוון ההפוך.

### 6.1 אפנון PWM(אפנון רוחב הפולס(

בבקרת PWM משתמשים בתהליך בו המתח יכול לקבל שני ערכים: 0 )אפס( או +V.

תהליך מיתוג המתח הוא תהליך מחזורי, שבו מסומן זמן המחזור ב-T. כל מחזור מחולק לשניים

בחלק אחד, המתמשך
Toff

שניות - המתח המסופק הוא 0 )אפס(, וביתרת המחזור, במשך

.V+ הוא | המתח | - T | T T on | off
=-

זמן המחזור של כל גל מסומן ב-T, משך הזמן בו נמצא הגל במצב מתח On מסומן ב-
TOn

, ומשך

.Toff

הזמן בו נמצא הגל במצב מתח Off מסומן ב-

הבקרה שאיתה אנו משתמשים במקרה של הפרויקט שלנו היא בקרה על זווית מנועי הסרבו בתוך מנוע הסרבו ישנה בקרה אשר יודעת באיזה זווית נמצא עכשיו המנוע ועל ידי נתינת פולס של PWM המנוע יודע לאיזו זווית רצויה הוא צריך להגיע.

בשיטה זו מפעילים ומנתקים בתדירות גבוהה את מקור המתח המחובר לצרכן )נגד או מנוע(; כך מתקיים תהליך שבו על הצרכן שורר מתח כתלות בזמן בעל אופי של גל ריבועי. מאפייני הפונקציה של מיתוג מקור המתח קובעים את ההספק הממוצע שמקבל הצרכן.

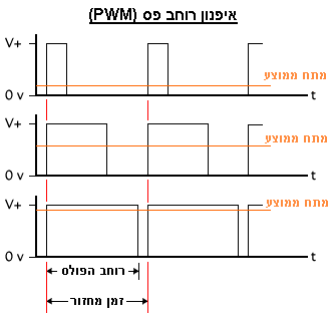
[picture p71: figure]

במקרה שלנו השימוש באיפנון PWM הוא שונה , בפרויקט שלנו איפנון הPWM פועל באופן הבא: הבקרה שאיתה אנו משתמשים במקרה של הפרויקט שלנו היא בקרה על זווית מנועי הסרבו בתוך מנוע הסרבו ישנה בקרה אשר יודעת באיזה זווית נמצא עכשיו המנוע ועל ידי נתינת פולס של PWM המנוע יודע לאיזו זווית רצויה הוא צריך להגיע.

בנוסף הזווית המקסימלית שאליה מגיע מנוע הסרבו בזמן של ms2 היא 120 מעלות.

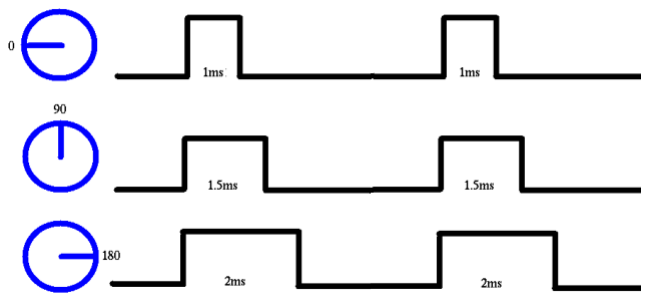
[picture p72: figure]

### 6.1 מד מרחק (04SR(

חיישן מרחק אולטרה סוני משדר וקולט גל בתחום אולטרה סוני ) מעבר לתדר השמיעה( , בתדירות KHZ

.40 החיישן משדר פולס בפרק זמן של 8 מחזורים בתדר KHZ 40 וממתין לקבלת הד חוזר. תפקידו לגלות מרחק של גופים ממעגל המשדר- מקלט.

מבנה פיזי

מאפיינים

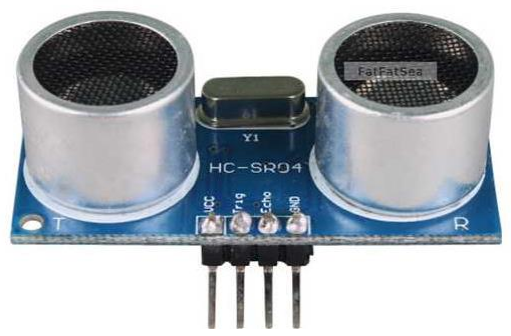
[picture p73: figure]

- מתח ספק - 5 וולט
- זרם – mA 15 אופייני.
. 40KHz – | תדירות | •
- טווח מקסימאלי – 4 מטר.
- טווח מינימאלי – 2 ס"מ .
- רגישות – גילוי בקוטר 3 ס"מ עד מרחק גדול מ 2 מטר.
- פולס התנעה – פולס של מינימום 10 מיקרו שניות ברמת מתח TTL .
- פולס הד – אות TTL חיובי ברוחב התלוי בטווח.
45mm*20mm*15mm – | קטנות | מידות | •

עקרון המדידה

גל הקול מתפשט בחלל פוגע בעצם וחוזר למקלט, כלומר מבצע דרך השווה לפי 2 מהמרחק של העצם מהחיישן. מהירות התפשטות גל הקול שווה למהירות הקול לכן הזמן שלוקח לגל הקול מרגע השידור עד לחזרתו הוא יחסי ליניארי למרחק של העצם מהחיישן. בפרויקט אנו מודדים את הזמן ובאמצעותו מציגים את המרחק.

מהירות הקול תלויה בתווך בו עובר הקול ובלחץ. בגובה פני הים מהירות הקול היא 1200 ק"מ/שעה שהם 333.33 מטר לשנייה.

| | ערך המרהK( מהירות( V( טמפרטורה( C ºt
0 | 331.5 | 60
10 | 337.5 | 59
20 | 343.5 | 58
30 | 349.5 | 57
40 | 355.5 | 56
50 | 361.5 | 55

בחרנו לעבוד עם ערך המרה 58=K כאשר טמפרטורת העבודה שלנו היא 20 מעלות.

אנו מעוניינים לקבל את המרחק מהחיישן ביחידות CM ולכן יש להמיר את המהירות ל US/CM, להלן הדרך:

| 340 | /
340*100 | 34000 | /
1sec 1
1000000
34000 ( | / | ) | 0.034 | /
1000000
2 | 2 | 58.823
( | / | ) | 0.034
v | m | s
v | cm | cm | s

us

v cm | us | cm | us

k
v cm us

=
= | =

=

= | =
= | = | =

7DC Motor 9.5

מנוע חשמלי הוא מכונה הממירה אנרגיה חשמלי למכנית. מנוע חשמלי מבוסס על עיקרון האלקטרומגנטיות. המאפשר יצירת שדה מגנטי על ידי העברת זרם חשמלי דרך סליל.

המנוע החשמלי בנוי על פי רוב משני חלקים עיקריים:

4( סטטור :(Stator (מערכת סלילים המלופפים סביב ליבה פֵ רוֹמגנטית (Core Ferromagnetic( המקובעת למקומה. הסטטור יכול להיות מורכב גם משני מגנטים רבי עוצמה. המגנטים מסודרים כך שקוטביהם )צפון ודרום( המופנים לכיוון הרוטור מנוגדים.

1( רוטור :(Rotor (ציר העובר בתוך הסטטור ועליו מלופפים שלושה סלילים .ציר זה חופשי להסתובב. כאשר זורם זרם חשמלי דרך הסלילים שברוטור, נוצר שדה מגנטי סביבם )דרך הליבה(. שדה מגנטי זה מפעיל כוח על הציר העובר דרכו, וזה מסתובב עקב המומנט) כח סיבובי(. העברת זרם חשמלי מקוטע, בצורה מבוקרת, מאפשרת צירוף תנועות זוויתיות קטנות לסיבובים שלמים.

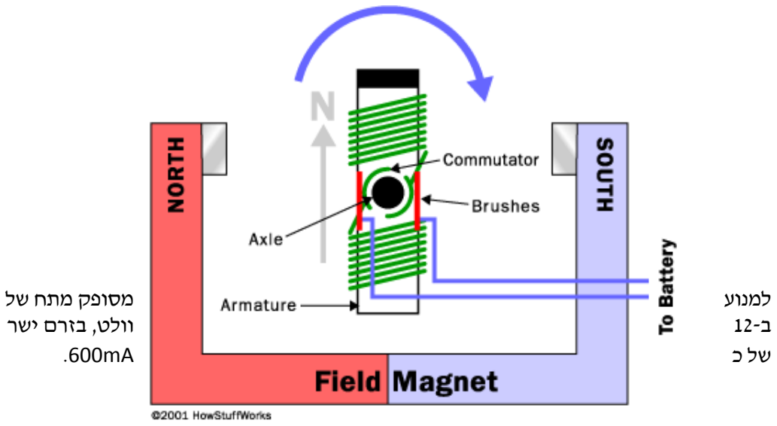
[picture p74: figure]
למנוע מסופק מתח של ב12- וולט, בזרם ישר של כ mA.600

### 6.3 מנועי סרבו (SERVO (7

מנוע סרוו הוא מנוע זרם ישר )Motor DC )בעל מערכת תמסורת פנימית של גלגלי שיניים ובקרה אלקטרונית על מיקום המנוע. מה שמיחד מנועי סרוו היא העובדה שהם אינם מסתובבים בצורה חופשית כמו מנועי DC, אלא נעים על פי זווית – לרוב בין 0 ל180- מעלות.

מנועי סרוו פועלים בחוג סגור, כלומר הינם בעלי בקרה על מיקום המנוע, ובעלי יכולת תיקון פערים מהמיקום הרצוי.

שליטה במנועי סרוו מבוצעת על ידי שליחת אות דיגיטאלי אל חוט הבקרה של המנוע. הרעיון הכללי הוא שליחת גל מרובע )Wave Square )אל המנוע, כאשר אורך הגל הוא זה שקובע את הזווית אליה ינוע המנוע.

לדוגמה, כאשר נספק למנוע גל בו רוחב הפולס הוא 1מילי-שנייה, המנוע ינוע אל זוויתו המינימאלית – 0 מעלות.
כאשר נספק למנוע גל בו רוחב הפולס הוא 1.5 מילי-שנייה, המנוע ינוע אל זוויתו האמצעית – 90 מעלות.
כאשר נספק למנוע גל בו רוחב הפולס הוא 2 מילי-שנייה, המנוע ינוע אל זוויתו הגדולה ביותר – 180 מעלות.

תרשים סכמטי:

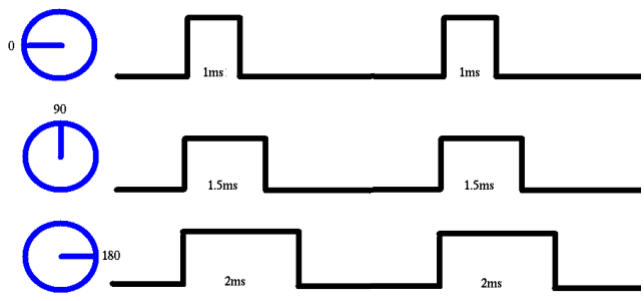
[picture p75: figure]

בכרטיס העבודה ישנם 2 מנועים כאלו שנתיבי המיד שלהם מחוברים אל 1_0P0,_0P הם מרכיבים בעצם את הזרוע המכנית.

במקרה שלנו מנוע הסרבו בזמן ms2 הזווית היא 120 מעלות.

### 9.7 מייצב ממותג מסוג BUCK) Down Step(

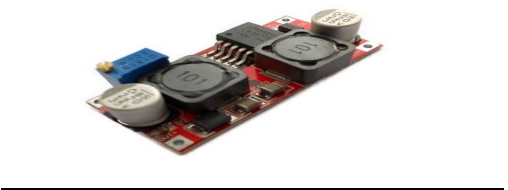
[picture p76: figure]

ממיר BUCK הוא ממיר המיועד להוריד מתח. ממיר זה אינו מבודד, כלומר אין הפרדה חשמלית בין מתח הכניסה ומתח היציאה. לאחרונה פותחו לממיר זה מספר שיטות המאפשרות נצילות גבוהה מ- 90% , על-ידי שימוש במתג סינכרוני במקום הדיודה להורדת הפסדי הולכה, ומיתוג בזרם אפס או מתח אפס כך שאין הפסדי מיתוג.

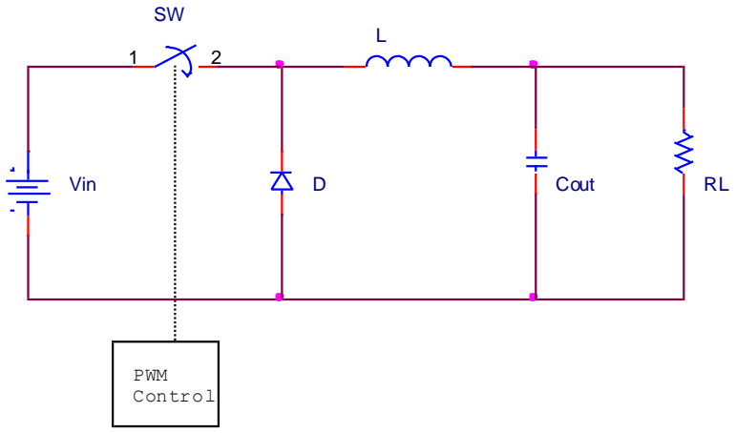
[picture p77: figure]
PWM Control; Vin; Cout

למעגל שני מצבים:

.1 כאשר המתג SW במצב ON , הסליל L מעביר מתח למוצא ונטען ממתח הכניסה. .2 כאשר המתג SW במצב OFF, הסליל L מעביר מתח למוצא ומתפרק דרך נגד העומס.
VL=LdIL/dt

המתג סגור (Ton(:

שיפוע הזרם חיובי ולכן במצב זה המתח על פני הסליל:

VL= Vin-Vout

המתג פתוח (Toff(

שיפוע הזרם שלילי ולכן במצב זה המתח על פני הסליל:

VL=Vout

כאשר הממיר במצב יציב, ממוצע המתח על פני הסליל חייב להיות אפס ולכן מתקיים הקשר:

(Vin-Vout)ton = -(0-Vout)toff

L

RL

SW

1 | 2
Vin | D | Cout

L

RL

SW

1 | 2
Vin | D | Cout

On

+ -

Off

פונקצית התמסורת:

Vout/Vin = ton/(ton+toff)=Don

צורות גלים:

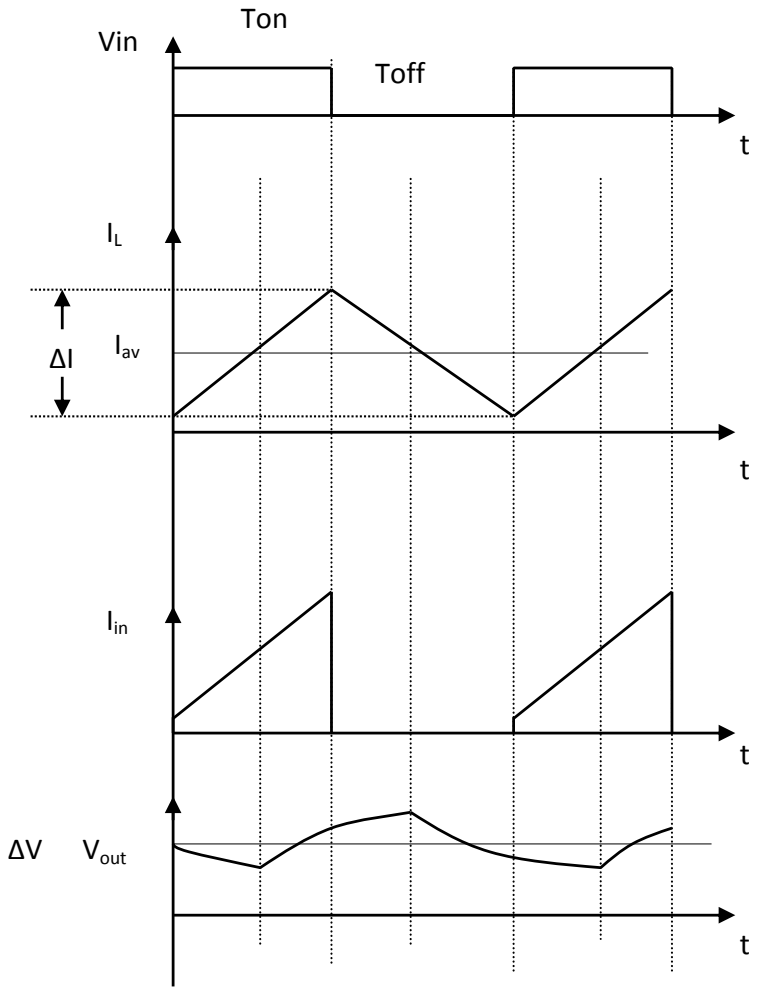
[picture p78: figure]
Vin; Iin; Vout; Ton; Toff; Iav
