YarinAVI/Practical-Engineer-Final-Project/schema updated(1).png

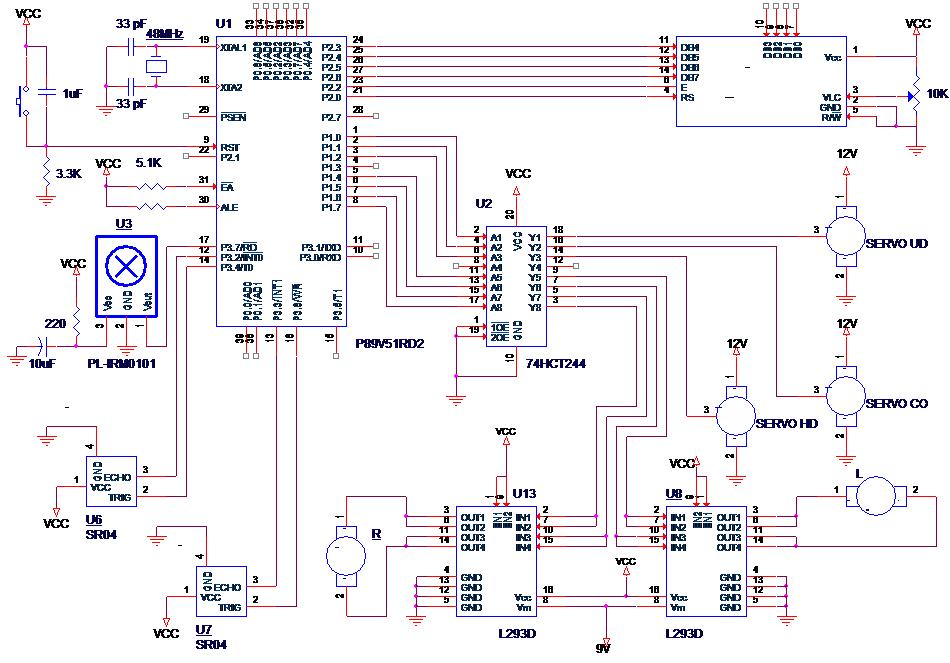
schema updated(1).png
