YarinAVI/Practical-Engineer-Final-Project/(list of files, cad)

Other CAD files:
program/Project/Objects/main.obj
program/Project/Objects/test_motors.obj
program/Project/Objects/robotBT.obj
program/Project/Objects/20 4.obj
program/Project/Objects/test_remote_ir.obj
program/Project/Objects/lior.obj
program/Project/Objects/lior(2).obj
program/Project/Objects/test_remote_ir(3).obj
program/Project/Objects/lior(4).obj
program/Project/Objects/test_remote_ir(4).obj
program/Project/Objects/test_remote_ir(1).obj
program/Project/Objects/test_remote_ir(2).obj
program/Project/Objects/lior(1).obj
program/Project/Objects/test_motors(1).obj
program/Project/Objects/lior(3).obj
