YarinAVI/Practical-Engineer-Final-Project/(list of files, drawings)

Other design files:
schema/BOX_COLLECTOR(1).DSN
schema/box_collector(1).opj
schema/BOX_COLLECTOR.DSN
schema/box_collector.opj
schema/schema/BOX_COLLECTOR.DSN
schema/schema/box_collector.opj
schema/schema/box_collector_0.opj
schema/schema/DESIGN1.DSN
schema/schema/Design1.opj
schema/schema/DESIGN2.DSN
schema/schema/Design2.opj
schema/schema/DESIGN3.DSN
schema/schema/Design3.opj
schema/schema/DESIGN4.DSN
schema/schema/Design4.opj
schema/schema/DESIGN5.DSN
schema/schema/Design5.opj
schema/schema/f3.opj
schema/schema/LIBRARY1.OLB
